MIT-STARLab/CLICK-A-Electronics/README.md

# CLICK-A-Electronics
Electronics for the CLICK-A payload
