MIT-STARLab/CLICK-A-Electronics/FPGA/BOM_FPGAboard.xlsx

Quantity | Designator | Manufacturer Part Number | Manufacturer | Supplier | Supplier Part Number | Description
1 | U4 | XC6SLX9-3TQG144I | Xilinx | Digikey | 122-1748-ND (https://octopart-clicks.com/click/altium?sku=122-1748-ND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) | IC FPGA 102 I/O 144TQFP
4 | SW1_B, SW1_E, SW1_H, SW1_T | TPS27082LDDCR | Texas Instruments (TI) | Digikey | 296-35595-1-ND (https://octopart-clicks.com/click/altium?sku=296-35595-1-ND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) | IC LOAD SW HIGH SIDE 6SOT
1 | CON3 | T1M-10-F-SH-L-K | Samtec | Digikey | SAM11993-ND (https://octopart-clicks.com/click/altium?sku=SAM11991-ND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) | 10 Positions Header Connector Surface Mount, Right Angle
1 | CON1 | T1M-06-F-SH-L-K | Samtec | Digikey | SAM11991-ND (https://octopart-clicks.com/click/altium?sku=SAM11991-ND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) | 6 Positions Header Connector Surface Mount, Right Angle
1 | U3 | CY7C68014A-56PVXC | Cypress | Digikey | 428-1673-ND (https://octopart-clicks.com/click/altium?sku=428-1673-ND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) | IC MCU USB PERIPH HI SPD 56SSOP
1 | U5 | LTM | Diodes / Zetex | Digikey | ZLDO1117G12DICT-ND (https://octopart-clicks.com/click/altium?sku=ZLDO1117G12DICT-ND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) | Linear Voltage Regulator IC Positive Fixed Output 1.2V 1A SOT-223-3
1 | U6 | PRTR5V0U2X,215 | NXP Semiconductors | Digi-Key | 1727-3884-1-ND (https://octopart-clicks.com/click/altium?sku=1727-3884-1-ND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) | TVS DIODE 5.5VWM SOT143B
1 | U7 | SN74LVC1G04QDBVRQ1 | Texas Instruments | Digi-Key | 296-26588-1-ND (https://octopart-clicks.com/click/altium?manufacturer=Texas%20Instruments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) | IC SNGL INVERTER GATE
1 | SW2 |  | ITT / C&K Components | C&K Components | CKN9112CT-ND (https://octopart-clicks.com/click/altium?manufacturer=Supplier%20disabled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) | PTS645SM43SMTR92 LFS
4 | P1, P2, P3, P4
1 | MCX | 73415-1066 | Molex |  |  | 73415-1061 Substitute may be OK (Contact customer for final approval)
4 | U1_B, U1_E, U1_H, U1_T | MCP6N11 | Microchip | Digi-Key | MCP6N11-010E/SN-ND (https://octopart-clicks.com/click/altium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) | IC OPAMP INSTR 35MHZ RRO 8SOIC
4 | U2_B, U2_E, U2_H, U2_T | MAX1240CESA+ | Maxim | Digikey | MAX1240CESA+-ND (https://octopart-clicks.com/click/altium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) | IC ADC 12BIT SERIAL 8-SOIC
1 | CON2 | LSEM-150-06.0-L-DV-A-N-K-TR | Samtec | Samtec | LSEM-150-06.0-L-DV-A-N-K-TR
1 | CON4 |  |  |  |  | Header, 13-Pin, Dual row
1 | CON5 |  |  |  |  | Header, 10-Pin
1 | Y1 | AT-24.000MAGE-T | TXC | Digikey | 887-1613-1-ND (https://octopart-clicks.com/click/altium?sku=887-1613-1-ND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) | 24MHz ±30ppm Crystal 12pF 50 Ohm -40°C ~ 85°C AEC-Q200 Surface Mount HC49/US
4 | R1_B, R1_E, R1_H, R1_T | WSLP0805R0100FEB | Vishay Dale | Digi-Key | WSLPB-.01CT-ND (https://octopart-clicks.com/click/altium?sku=WSLPB-.01CT-ND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) | 10 mOhms ±1% 0.5W, 1/2W Chip Resistor 0805 (2012 Metric)
4 | R2_B, R2_E, R2_H, R2_T | CRCW0805127KFKEA | Vishay | Digikey | 541-127KCCT-ND (https://octopart-clicks.com/click/altium?sku=541-127KCCT-ND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)
7 | R3_B, R3_E, R3_H, R3_T, R6, R9, R10 | CRCW080510K0FKEA_ | Vishay | Digikey | 541-10.0KCCT-ND (https://octopart-clicks.com/click/altium?sku=541-10.0KCCT-ND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)
4 | R4_B, R4_E, R4_H, R4_T | CRCW0805100RDHEAP | Vishay Dale | Digi-Key | 541-100AZCT-ND (https://octopart-clicks.com/click/altium?sku=541-100AZCT-ND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) | RES SMD 100 OHM 0.5% 1/8W 0805
5 | R5_B, R5_E, R5_H, R5_T, R11 | CRCW08050000Z0EA | Vishay | Digikey | 541-0.0ACT-ND (https://octopart-clicks.com/click/altium?sku=541-0.0ACT-ND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)
2 | R7, R8 | CRCW08052K20FKEA | Vishay | Digikey | 541-2.20KCCT-ND (https://octopart-clicks.com/click/altium?sku=541-2.20KCCT-ND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)
1 | OSC1 | ASVMB-100.000MHZ-XY-T | Abracon | Digikey | 535-11246-1-ND (https://octopart-clicks.com/click/altium?sku=535-11246-1-ND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)
6 | C3_B, C3_E, C3_H, C3_T, C28, C29 | C1210C476M8RAC7800 | Kemet | Digikey | 399-12072-1-ND (https://octopart-clicks.com/click/altium?sku=399-12072-1-ND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)
10 | C1_B, C1_E, C1_H, C1_T, C4_B, C4_E, C4_H, C4_T, C24, C25 | C0805C106M8RACTU | Kemet | Digikey | 399-7413-1-ND (https://octopart-clicks.com/click/altium?sku=399-7413-1-ND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)
2 | C20, C23 | C0805C474K5RACTU | Kemet | Digikey | 399-8100-1-ND (https://octopart-clicks.com/click/altium?sku=399-8100-1-ND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)
2 | C21, C22 | C0805C120J5GACTU | Kemet | Digikey | 399-1110-1-ND (https://octopart-clicks.com/click/altium?sku=399-1110-1-ND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)
38 | C2_B, C2_E, C2_H, C2_T, C5_B, C5_E, C5_H, C5_T, C6, C7, C8, C9, C10, C11, C12, C13, C14, C15, C16, C17, C18, C19, C26, C27, C30, C31, C32, C33, C34, C35, C36, C37, C38, C39, C40, C41, C42, C43 | C0805C104K5RACTU | Kemet | Digikey | 399-1170-1-ND (https://octopart-clicks.com/click/altium?sku=399-1170-1-ND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)
