MIT-STARLab/CLICK-A-Electronics/Rpi Board/RPIadaptorV3_BOM.xlsx

MPN | Designator | LibRef | Supplier 1 | Supplier Part Number 1 | Description | Quantity | Value
C1210C476M9PACTU (https://www.digikey.com/product-detail/en/kemet/C1210C476M9PACTU/399-4961-1-ND/1090956) | C4, C20, C26 | C1210C476M8RAC7800 | Digikey | 399-12072-1-ND |  | 3
C0805C106M8RACTU | C5, C16, C17 | C0805C106M8RACTU | Digikey | 399-7413-1-ND |  | 3
GRT21BC80G476ME13L (https://www.digikey.com/product-detail/en/murata-electronics/GRT21BC80G476ME13L/490-12339-1-ND/5417040) | C6, C7 | CAP 0805 |  |  | 0805 CAP, 805 Capacitor | 2 | 47uF
CL05F104ZO5NNNC | C8, C23, C31, C32, C35, C36, C37, C39, C40, C42, C44 | CAP 0402 |  |  | [NoValue], 402 Capacitor, CBR04C680F3GAC, 402 cap | 11 | [NoValue], .1uF
C0603C104Z3VACTU (https://www.digikey.com/product-detail/en/kemet/C0603C104Z3VACTU/399-1100-1-ND/411375) | C9 | CAP 0603 |  |  | 603 Capacitor | 1
C0402C270K5GACTU (https://www.digikey.com/product-detail/en/kemet/C0402C270K5GACTU/399-8960-1-ND/3522477) | C10, C11 | CAP 0402 |  |  |  | 2
GRM21BR60J476ME15L | C14 | CMP-1036-04876-1 |  |  | GRM21BR60J476ME15L | 1 | 4.7uF
C0805C104K5RACTU (https://www.digikey.com/product-detail/en/kemet/C0805C104K5RACTU/399-1170-1-ND/411445) | C15, C18, C19, C25, C27 | C0805C104K5RACTU | Digikey | 399-1170-1-ND |  | 5
GRM21BR61E226ME44L (https://www.digikey.com/product-detail/en/murata-electronics/GRM21BR61E226ME44L/490-10749-1-ND/5251351) | C24, C28 | CAP 0805 |  |  | 805 Capacitor | 2
GRM21BR61A226ME51L (https://www.digikey.com/product-detail/en/murata-electronics/GRM21BR61A226ME51L/490-10511-1-ND/5026441) | C29 | CAP 0805 |  |  | 805 Capacitor | 1
GRM188C81E475KE11D (https://www.digikey.com/product-detail/en/murata-electronics/GRM188C81E475KE11D/490-7199-1-ND/3900424) | C30 | CMP-1035-01192-1 |  |  | GRM188C81E475KE11D | 1
CC0805KRX5R5BB475 (https://www.digikey.com/product-detail/en/yageo/CC0805KRX5R5BB475/311-3422-1-ND/7164443) | C38 | CAP 0805 |  |  | 805 Capacitor | 1
C0402C105K9PACTU (https://www.digikey.com/product-detail/en/kemet/C0402C105K9PACTU/399-4873-1-ND/1090868) | C41, C45, C47 | CAP 0402 |  |  | [NoValue], 402 cap, 402 | 3
CC0402KRX7R9BB332 (https://www.digikey.com/product-detail/en/yageo/CC0402KRX7R9BB332/311-1034-1-ND/302951) | C43 | CAP 0402 |  |  |  | 1
GJM1555C1H140GB01D (https://www.digikey.com/product-detail/en/murata-electronics/GJM1555C1H140GB01D/490-14443-1-ND/6606904) | C46, C48 | CAP 0402 |  |  | CBR04C680F3GAC | 2
T1M-06-F-SH-L-K | CON1, CON2, CON6 | T1M-06-F-SH-L-K | Digi-Key | SAM11991-ND | 6 Positions Header Connector Surface Mount, Right Angle | 3
0532610671 | CON3 | 0532610671 | Digi-Key | WM7624CT-ND | CONN HEADER 6POS 1.25MM R/A SMD | 1
T1M-10-F-SH-L-K | CON4 | T1M-10-F-SH-L-K |  |  | 10 Positions Header Connector Surface Mount, Right Angle | 1
1473005-4 | CON5 | 1473005-4 | Digikey | A114851-ND |  | 1
929834-01-36-RK (https://www.digikey.com/product-detail/en/3m/929834-01-36-RK/3M156862-36-ND/1239201) | CON7 | 1X6 Header |  |  |  | 1
 | P1 | Header 5X2 |  |  | Header, 5-Pin, Dual row | 1
 | P2 | Header 10 |  |  | Header, 10-Pin | 1
 | P3 | Header 9X2 |  |  | Header, 9-Pin, Dual row | 1
 | P4, P5, P6, P7 | Plug |  |  | Plug | 4
DMG1012T-7 | Q1, Q2 | DMG1012T-7 | Digikey | DMG1012T-7DICT-ND | N-Channel MOSFET | 2
 | R1, R2, R23, R24 | RES 0402 |  |  | 402 Resistor | 4
ERA-2AEB473X (https://www.digikey.com/product-detail/en/panasonic-electronic-components/ERA-2AEB473X/P47KDCCT-ND/1706223) | R7, R8, R21, R22, R26 | RES 0402 |  |  | 402 Resistor | 5
CRCW080510K0FKEA_ESTE | R9 | CRCW080510K0FKEA_ESTE | Digikey | 541-10.0KCCT-ND |  | 1
ERA-2AEB1332X (https://www.digikey.com/product-detail/en/panasonic-electronic-components/ERA-2AEB1332X/P13-3KDCCT-ND/3063672) | R14 | RES 0402 |  |  | 402 Resistor | 1
RT0402BRD078K25L (https://www.digikey.com/product-detail/en/yageo/RT0402BRD078K25L/YAG1487CT-ND/5138935) | R15 | RES 0402 |  |  | 402 Resistor | 1
ERA-3AEB3243V (https://www.digikey.com/product-detail/en/panasonic-electronic-components/ERA-3AEB3243V/P324KDBCT-ND/3075930) | R16 | RES 0603 |  |  | 603 Resistor | 1
ERA-2AEB123X (https://www.digikey.com/product-detail/en/panasonic-electronic-components/ERA-2AEB123X/P12KDCCT-ND/1706209) | R17 | RES 0402 |  |  | 402 Resistor | 1
ERJ-2GEJ102X (https://www.digikey.com/product-detail/en/panasonic-electronic-components/ERJ-2GEJ102X/P1-0KJCT-ND/146897) | R20 | RES 0402 |  |  | 402 Resistor | 1
ERA-2AEB4021X (https://www.digikey.com/product-detail/en/panasonic-electronic-components/ERA-2AEB4021X/P4-02KDCCT-ND/3063803) | R25 | RES 0402 |  |  | 402 Resistor | 1
RC0402FR-07100KL (https://www.digikey.com/product-detail/en/yageo/RC0402FR-07100KL/311-100KLRCT-ND/729473) | R27 | RES 0402 |  |  | 402 Resistor | 1
ERA-2AED103X (https://www.digikey.com/product-detail/en/panasonic-electronic-components/ERA-2AED103X/P10KDECT-ND/1706304) | R32 | RES 0402 |  |  | 402 Resistor | 1
LTM4622IY | U1 | LTM4622 |  |  | Dual Ultrathin 2.5A or Single 5A Step-Down DC/DC µModule Regulator | 1
LM1117MPX-1.8/NOPB | U2 | LM1117MPX-1.8/NOPB | Digikey | LM1117MPX-1.8/NOPBCT-ND | LDO | 1
PRTR5V0U2X,215 | U3, U6 | PRTR5V0U2X,215 | Digi-Key | 1727-3884-1-ND | TVS DIODE 5.5VWM SOT143B | 2
USB2422T-I/MJ (https://www.digikey.com/product-detail/en/microchip-technology/USB2422T-I-MJ/USB2422T-I-MJDKR-ND/8637360) | U4 | USB2422 |  |  |  | 1
TPS259573DSGR (https://www.digikey.com/product-detail/en/texas-instruments/TPS259573DSGR/296-50501-1-ND/9685640) | U5 | TPS2595x3 |  |  |  | 1
FSUSB42MUX | U7 | FSUSB42 | Digikey | FSUSB42MUXDKR-ND | 2 ports USB switch | 1
SN65LVDS33D | U8 | SN65LVDS33 |  |  |  | 1
SN65LVDS9638DR | U9 | SN65LVDS9638 |  |  |  | 1
VNC2-48L1C-REEL | U10 | VNC2L |  |  |  | 1
7A-12.000MAAE-T | Y2 | 7A-12.000MAAE-T |  |  |  | 1
7A-24.000MAAE-T (https://www.digikey.com/product-detail/en/txc-corporation/7A-24-000MAAE-T/887-1751-1-ND/3518801) | Y3 | 7A-12.000MAAE-T |  |  |  | 1
