MIT-STARLab/CLICK-A-Electronics/Photodiode Board/PhotodiodeBoard.xlsx

Comment | Description | Designator | Footprint | LibRef | Quantity
0.1uF |  | C1, C2, C5, C12, C14, C16, C17, C20, C22, C23, C26, C29, C32 | 0402 | Cap 0402 | 13
2.2uF |  | C3, C6, C11, C18, C21, C24, C27, C28, C31 | 0402 | Cap 0402 | 9
1000p |  | C4, C19, C25 | 0402 | Cap 0402 | 3
22uF |  | C7, C8, C10 | 0603 | Cap 0603 | 3
.1uF |  | C9 | 0402 | Cap 0402 | 1
10uF | tantalum bead type cap | C13 | 0603 | Cap 0603 | 1
10p |  | C15, C30, C33 | 0402 | Cap 0402 | 3
T1M-15-F-SH-L-K |  | CON1 | T1M-15-F-SH-L-K | T1M-15-F-SH-L-K | 1
EPM605 |  | D1, D3, D5 | EPM605 | EPM605 | 3
1N4148 | Fast switching diode SMD | D2, D4, D6 | SOD3716X135N | 1N4148 | 3
0 |  | R1, R13, R24 | 0402 | Res 0402 | 3
20K |  | R2, R8, R14, R20, R25, R32 | 0402 | Res 0402 | 6
15K |  | R3, R15, R26 | 0402 | Res 0402 | 3
49.9 |  | R4, R16, R27 | 0402 | Res 0402 | 3
DNP | 0 ohm | R5, R6, R17, R18, R29, R30 | 0402 | Res 0402 | 6
1K |  | R7, R19, R31 | 0402 | Res 0402 | 3
22K |  | R9, R11, R21, R23, R33, R35 | 0402 | Res 0402 | 6
2K |  | R10, R22, R34 | 0402 | Res 0402 | 3
6.65K |  | R12, R28, R36 | 0402 | Res 0402 | 3
LTC6752 |  | U1, U2, U4, U5, U6, U8, U9, U10, U12 | TSOT-23 5 Lead | LTC6752 | 9
LTC6268-10 |  | U3, U7, U11 | TSOT-23 6 Lead | LTC6268-10 | 3
AD5666ARUZ-2REEL7 | Integrated Circuit | U13 | TSSOP-14 | AD5666ARUZ-2REEL7 | 1
