MIT-STARLab/CLICK-A-Electronics/Daughterboard/Daughter_Board_rev_16_updated.xls

Manufacturer part number | Comment | Description | Designator | Footprint | LibRef | Quantity
LMF105B7102MVHF | 1000pF | 0402 (1005 Metric) Nick Garner - TeleSense | C1, C32, C33, C34 | 0402 B | CAP_0402 | 4 | x
C0603C106M8PACTU | 10uF | CAPACITOR, European symbol | C2, C5, C8, C11, C14, C17, C29, C57, C88 | 603 | C-EUC0603K | 9 | x
C0402C104M4RECTU | 0.1uF | CAPACITOR, European symbol, 0402 (1005 Metric) Nick Garner - TeleSense | C3, C6, C9, C12, C15, C18, C19, C20, C21, C22, C23, C25, C26, C27, C37, C38, C43, C44, C53, C55, C48, C49, C50, C51, C52,C56,C80,C83,C86 | 0402 B | C-EUC0402K, CAP_0402, C-EUC0402 | 30 | x
C0603C105Z3VACTU | 1uF | CAPACITOR, European symbol | C4, C16 | 603 | C-EUC0603 | 2 | x
GRM188R60J226MEA0D | 22uF | CAPACITOR, European symbol | C7, C13, C79 | 603 | C-EUC0603 | 3 | x
C1812C106K3RACAUTO | 10uF | CAPACITOR, European symbol | C10 | C1812 | C-EUC1812 | 1 | x
DNI | C-EUC0603 | CAPACITOR, European symbol | C24 | 603 | C-EUC0603 | 1
C0603C104Z3VACTU | 0.1uF | CAPACITOR, European symbol | C28, C30, C31, C35, C74, C81 | 603 | C-EUC0603K, C-EUC0603 | 5 | x
CC0402KPX5R7BB105 | 1uF | 402 Capacitor | C36, C39, C60,C45, C46, C47, C76 | 0402 B | CAP 0402 | 7 | x
C0603X103K1RAC3316 | 0.01uF | CAPACITOR, European symbol | C40, C41 | 603 | C-EUC0603K | 2 | x
C0402C473K3RECTU | 47nF | 402 Capacitor | C42 | 0402 B | CAP 0402 | 1 | x
C0402C332K5RECAUTO | 3.3nF | 402 Capacitor | C54 | 0402 B | CAP 0402 | 1 | x
C0402C474K9PAC | 47pF | 402 Capacitor | C58 | 0402 B | CAP 0402 | 1 | x
GRM188R60J476ME15J | 47uF |  | C59 | 603 | Cap 0603 | 1 | x
C0402C106M9PACTU | 10uF | 402 Capacitor | C61, C64 | 0402 B | CAP 0402 | 2 | x
12066D107MAT2A | 100uF | 1206 Capacitor | C62 | 1206 B | CAP 1206 | 1 | x
C0402C820J3GACAUTO | 82pF | 402 Capacitor | C63 | 0402 B | CAP 0402 | 1 | x
C0402T103J4RACTU | 10nF | 402 Capacitor | C65 | 0402 B | CAP 0402 | 1 | x
TMK107BBJ475MA-T | 4.7uF | CAPACITOR, European symbol | C75 | 603 | C-EUC0603 | 1 | x
AMK105EBJ226MV-F | 22uF | CAPACITOR, European symbol | C77, C78 | 402 | C-EUC0402 | 2 | digikey
C0402S331K5RAC7867 | 330pF | CAPACITOR, European symbol | C82 | 402 | C-EUC0402 | 1 | x
T1M-07-F-SH-L-K | T1M-07-F-SH-L-K | 6 Positions Header Connector Surface Mount, Right Angle | CON1,CON4 | T1M-07-F-SH-L-K | T1M-07-F-SH-L-K_1 | 2 | x
T1M-06-F-SH-L-K | T1M-06-F-SH-L-K | 6 Positions Header Connector Surface Mount, Right Angle | CON2, CON3 | T1M-06-F-SH-L-K | T1M-06-F-SH-L-K | 2 | x
 | DNP | SAMTEC connector | CON5 | LSEM-150-XX.X-X-DV-A-X-XX-TR | SAMTEC_LSEM_V_50 | 1
MBR120VLSFT1G | MBR120VLSFT1G | DIODE SCHOTTKY 20V 1A | D1 | SOD123FL | MBR120VLSFT1G | 1 | x
MM3Z5V1ST1GOSCT-ND | MM3Z5V1ST1GOSCT-ND | MM3Z5V1ST1GOSCT-ND | D4 | SOD-323 | DIODE-ZENER3.3V | 1 | digikey
GF1G | GF1G | DIODE | D5 | SMA-DO214AC | GF1 | 1 | x
MM3Z3V3T1GOSCT-ND | MM3Z3V3T1GOSCT-ND | Zener Diode Production Part - 8199 3.4V Zener Voltage | D6 | SOD-323 | DIODE-ZENER3.3V | 1 | digikey
MCP1541 | MCP1541 | 2.5V and 4.096V Voltage ReferencesSource: http://www.microchip.com .. 21653b.pdf | U4 | SOT-23 | MC15*TT | 1 | x
CBC2518T100M | CBC2518T100M |  | L1 | 1007 | CBC2518T100M | 1 | x
NLC453232T-330K-PF | 33uH | INDUCTOR, American symbol | L3 | L1812 | L-USL1812 | 1 | x
74479763210 | FERRITE | InductorsBasic Inductor/Choke - 0603 and 1206. Footprints are not proven and vary greatly between part numbers.SRN6045- 33uH, 20% 1.4ASDR0403-560KL - 56uH, 10%, 500mA RMS/740mA peak | L5, L9, L10 | 0603R | INDUCTOR0603 | 3 | x
B82462G4103M | B82462G4103M | 10uH | L11, L12 | B82462G | INDUCTOR-B82462G | 2 | x
ERA-3AEB102V | 1k | RESISTOR, American symbol | R1, R2, R3, R4, R5, R7, R8, R9, R10, R11, R13, R14, R15, R16, R17, R19, R20, R21, R22, R23, R25, R26, R27, R28, R29, R31, R32, R33, R34, R35, R56, R77 | 0603R | R-US_R0603 | 32 | x
RCS06030000Z0EC | 0 | RESISTOR, American symbol | R6, R12, R18, R24, R30, R36 | 0603R | R-US_R0603 | 6 | x
SR0603FR-7T100RL | 100 | RESISTOR, American symbol | R37 | 0603R | R-US_R0603 | 1 | x
RN73R1JTTD1002B50 | 10k | RESISTOR, American symbol | R38, R59, R86 | 0603R | R-US_R0603 | 3 | x
 | DNP | RESISTOR, American symbol | R39 | 0603R | R-US_R0603 | 1
RC0402FR-0710KL | 10K | 402 Resistor | R40 | 402 | RES 0402 | 1 | x
PNM0402E5001BST1 | 18K2 | 402 Resistor | R41 | 402 | RES 0402 | 1 | x
ERA-2AEB303X | 30K | 402 Resistor | R42 | 0402R | RES 0402 | 1 | x
CRCW06034M99FKEA | 4.99M | RESISTOR, American symbol | R44, R45, R46, R47 | 0603R | R-US_R0603 | 4 | x
CRCW060390K9FKEAC | 90.9k | RESISTOR, American symbol | R48, R49, R50, R51 | 0603R | R-US_R0603 | 4 | x
ERA-3AEB104V | 100k | RESISTOR, American symbol | R52, R53, R57, R72, R73 | 0603R | R-US_R0603 | 5 | x
CSR1206FTR100 | 0.1 | RESISTOR, American symbol | R54 | 1206R | R-US_R1206 | 1 | Digikey
ERA-3AEB9091V | 9.09k | RESISTOR, American symbol | R55 | R0603 | R-US_R0603 | 1 | x
MCT06030C1005FP500 | 10M | RESISTOR, American symbol | R58 | 0603R | R-US_R0603 | 1 | x
CPF0603F6R81C1 | 6.81 | RESISTOR, American symbol | R60 | R0603 | R-US_R0603 | 1 | x
ERA-3AEB433V | 43k | RESISTOR, American symbol | R71 | 0603R | R-US_R0603 | 1 | x
ERA-3AEB1273V | 127k | RESISTOR, American symbol | R74 | 0603R | R-US_R0603 | 1 | x
RC1206JR-077M5L | 7.5M | RESISTOR, American symbol | R75 | 1206R | R-US_R1206 | 1 | x
MCT06030C3162FP500 | 31.6k | RESISTOR, American symbol | R76 | 0603R | R-US_R0603 | 1 | x
CRGCQ0402F82K | 82k | RESISTOR, American symbol | R83 | 0402R | R-US_R0402 | 1 | x
RC0402FR-0710KL | 10k | RESISTOR, American symbol | R84, R85 | 0402R | R-US_R0402 | 2 | x
TPS259541DSGR | TPS259541DSGR |  | U1 | SON8 (2x2) | TPS2595x3 | 1 | x
iC-WKN | iC-WKN |  | U2 | SOIC8tp | iC-WKN | 1 | iC-Haus
TPS6735IDR | TPS6735 |  | U3 | SOIC8 | TPS6735 | 1 | x
T1M-15-F-SH-L-K | T1M-15-F-SH-L-K |  | U5 | T1M-15-F-SH-L-K | T1M-15-F-SH-L-K | 1 | x
TLV5619IPW | TLV5619 |  | U6 | TSSOP-20 | TLV5619 | 1 | x
MCP6N11-001E/SN | MCP6N11 |  | U7, U9, U11, U17, U25, U29 | SOIC8 | MCP6N11 | 6 | x
MAX1240AESA+ | MAX1240 |  | U8, U10, U12, U21, U28, U30,U37 | SOIC8 | MAX1240 | 7 | x
AD5664RBRMZ-5 | AD5664R |  | U13 | MSOP10 | AD5664R | 1 | x
HV264 | HV264 |  | U14 | TSSOP24 | HV264 | 1 | microchip
MAX7413EUA+ | MAX7413 |  | U15, U16, U18, U19 | UMAX8 | MAX7413 | 4 | x
LTC1923EGN#PBF | LTC1923SSOP28 |  | U20 | SSOP28 | LTC1923SSOP28 | 1 | x
SI9801DY | SI9801DY |  | U22, U23 | SOIC8 | SI9801DY | 2 | utsource
LTC2053IMS8#PBF | LTC2053 |  | U24 | MSOP8 | LTC2053 | 1
TPS27082LDDCR | TPS27082L |  | U26, U27 | TSOT-23 6 Lead | TPS27082L | 2 | digikey
SI2334DS | SI2334DS |  | U31 | SOT-23 | SI2334DS | 1 | x
ADN8810ACPZ-ND | ADN8810 |  | U32 | LFCSP24 | ADN8810 | 1 | x
SHF-105-01-L-D-RA | SHF-105-01-L-D-RA |  | CON6 | SHF-105-01-L-D-RA | SHF-105-01-L-D-RA | 1 | x
ADUM7440CRQZ | ADUM7440 |  | U35 | QSOP16 | ADUM7440 | 1 | x
HV9150 | HV9150 |  | U42 | QFN3X3-6 | HV9150 | 1 | x
BSZ42DN25NS3 | BSZ42DN25NS3 |  | U43 | TDSON-8 | BSZ42DN25NS3 | 1 | x
TC33X-2-204E | 200k | SMT trimmer potentiometer part number TC33X http://www.ladyada.net/library/eagle | U44 | TC33X | TRIMPOTTC33X | 1 | x
791077014 | 87758-3016 | 30 Pin - 2mm Dual Row Single Wafer, Vertical T/H HDRSource: http://www.molex.com/pdm_docs/sd/877580616_sd.pdf | X1 | 87758-3016 | 87758-3016 | 1 | x
