MIT-STARLab/CLICK-A-Electronics/Calibration Laser Board/Calibration_Laser_Board.step

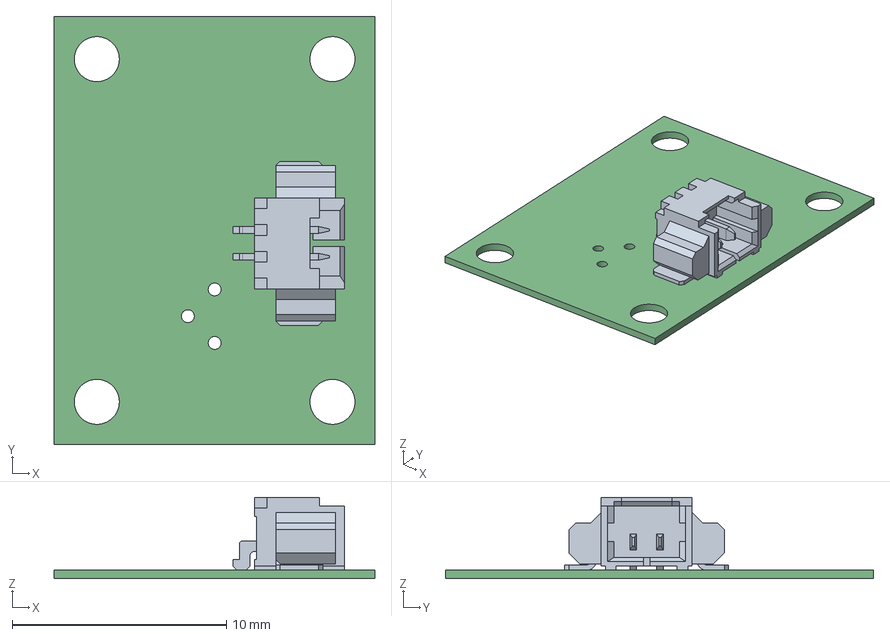
[picture p1: CAD file, 2020-10-06]
Calibration Laser Board/Calibration_Laser_Board.step
15.0 x 20.0 x 3.79 mm
Board
