MIT-STARLab/CLICK-A-Electronics/Photodiode Board/Photodiode Board.pdf

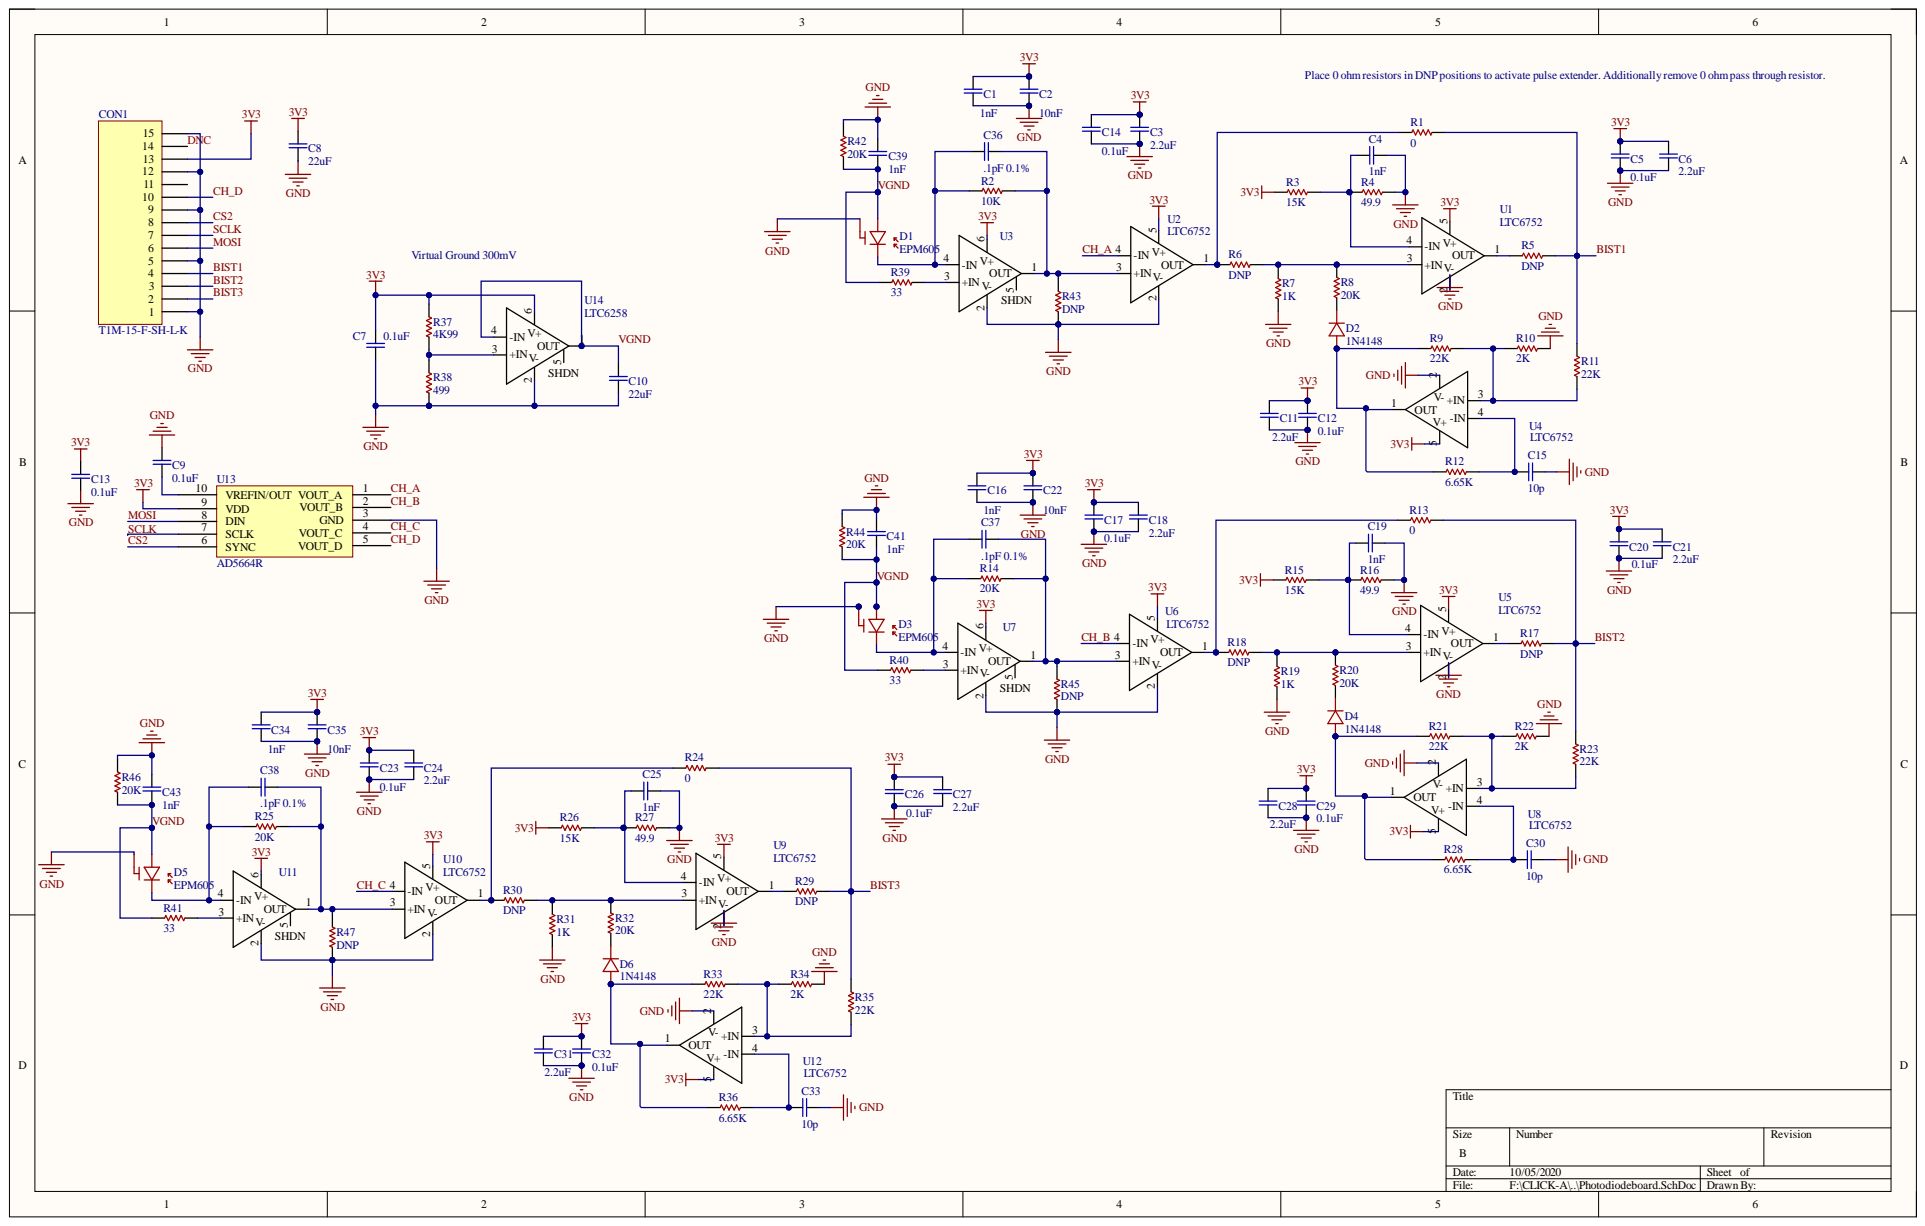
[picture p2: page 1]

Place 0 ohmresistors in DNP positions to activate pulse extender. Additionally remove 0 ohmpass through resistor.

Size B | Number | Revision

Date: 10/05/2020 | Sheet of
File: F:\CLICK-A\..\Photodiodeboard.SchDoc | DrawnBy:

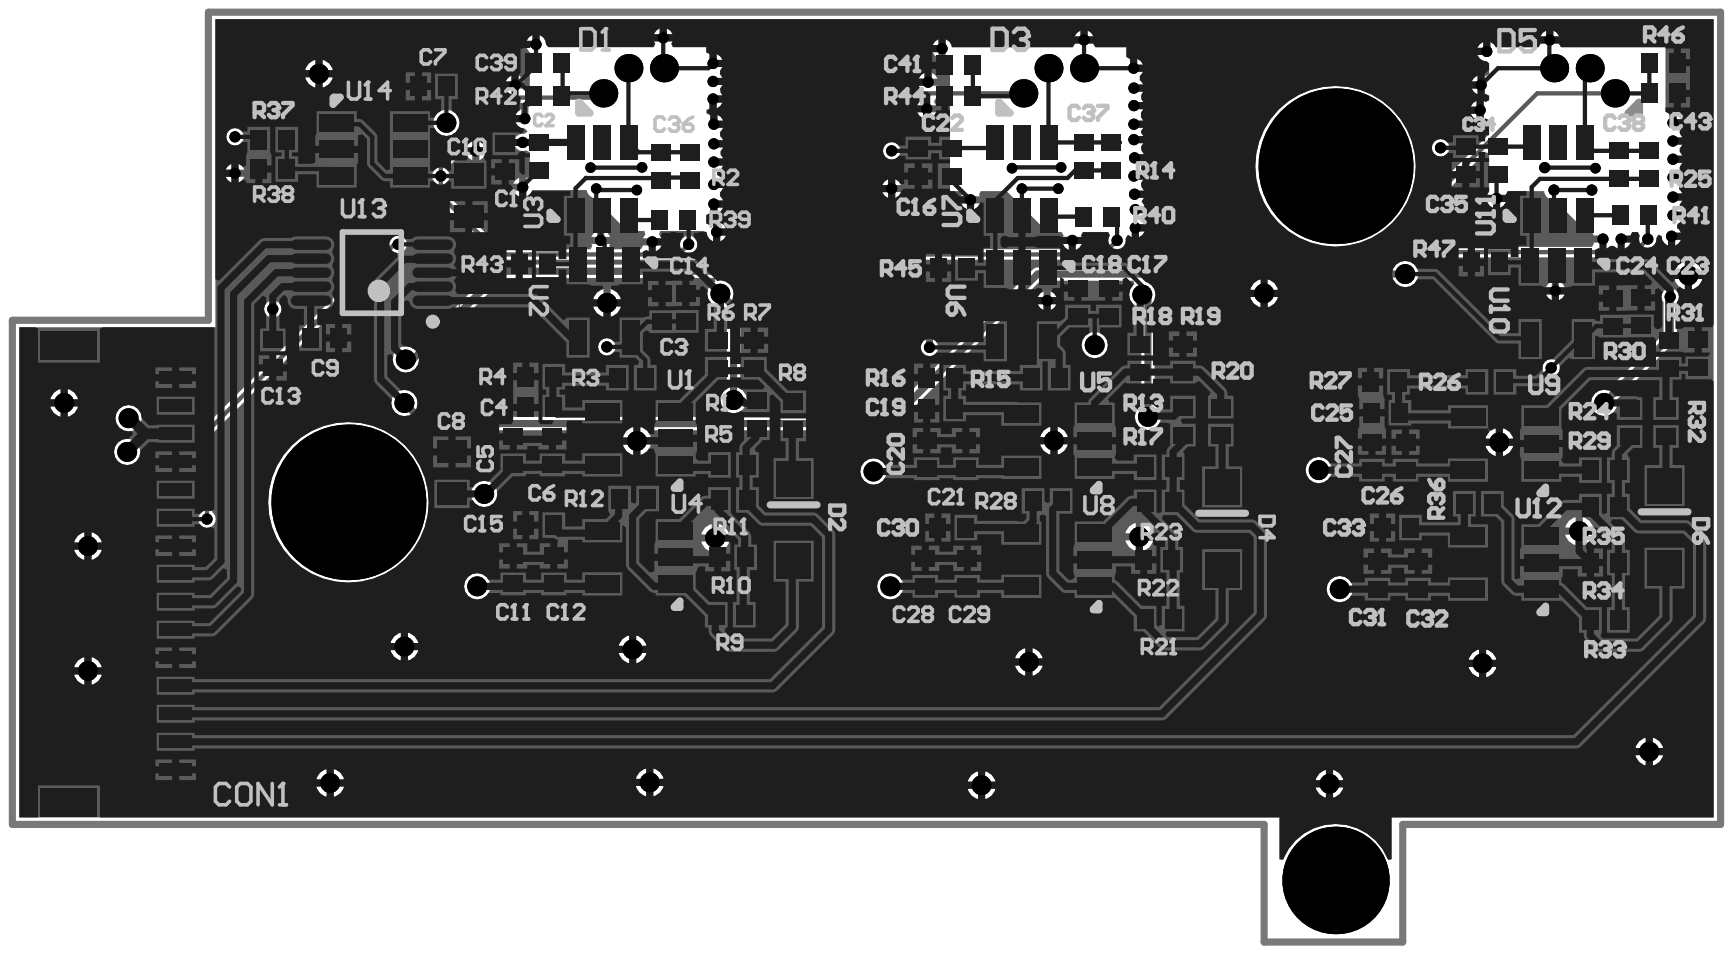
[picture p3: page 2]
