MIT-STARLab/CLICK-A-Electronics/Daughterboard/NODE_Daughter_Board_rev_16.pdf

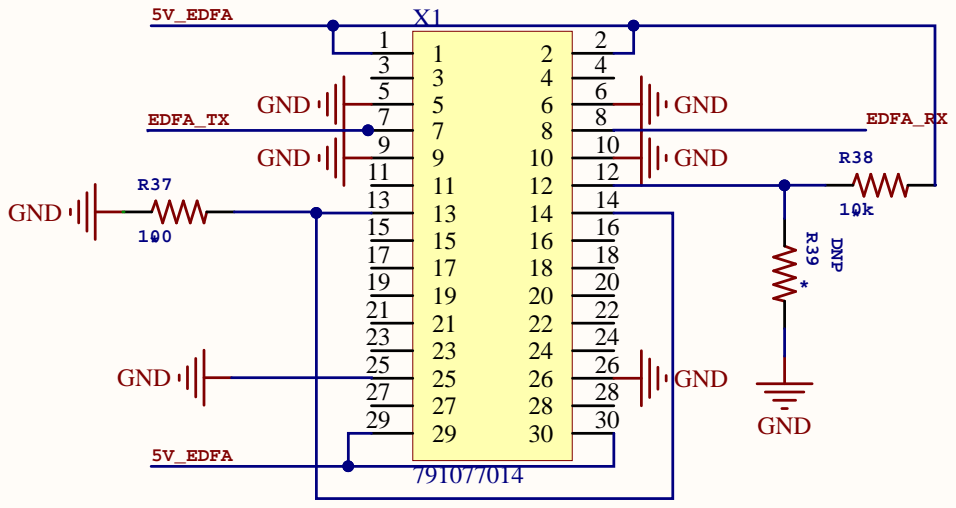
[picture p4: page 1]

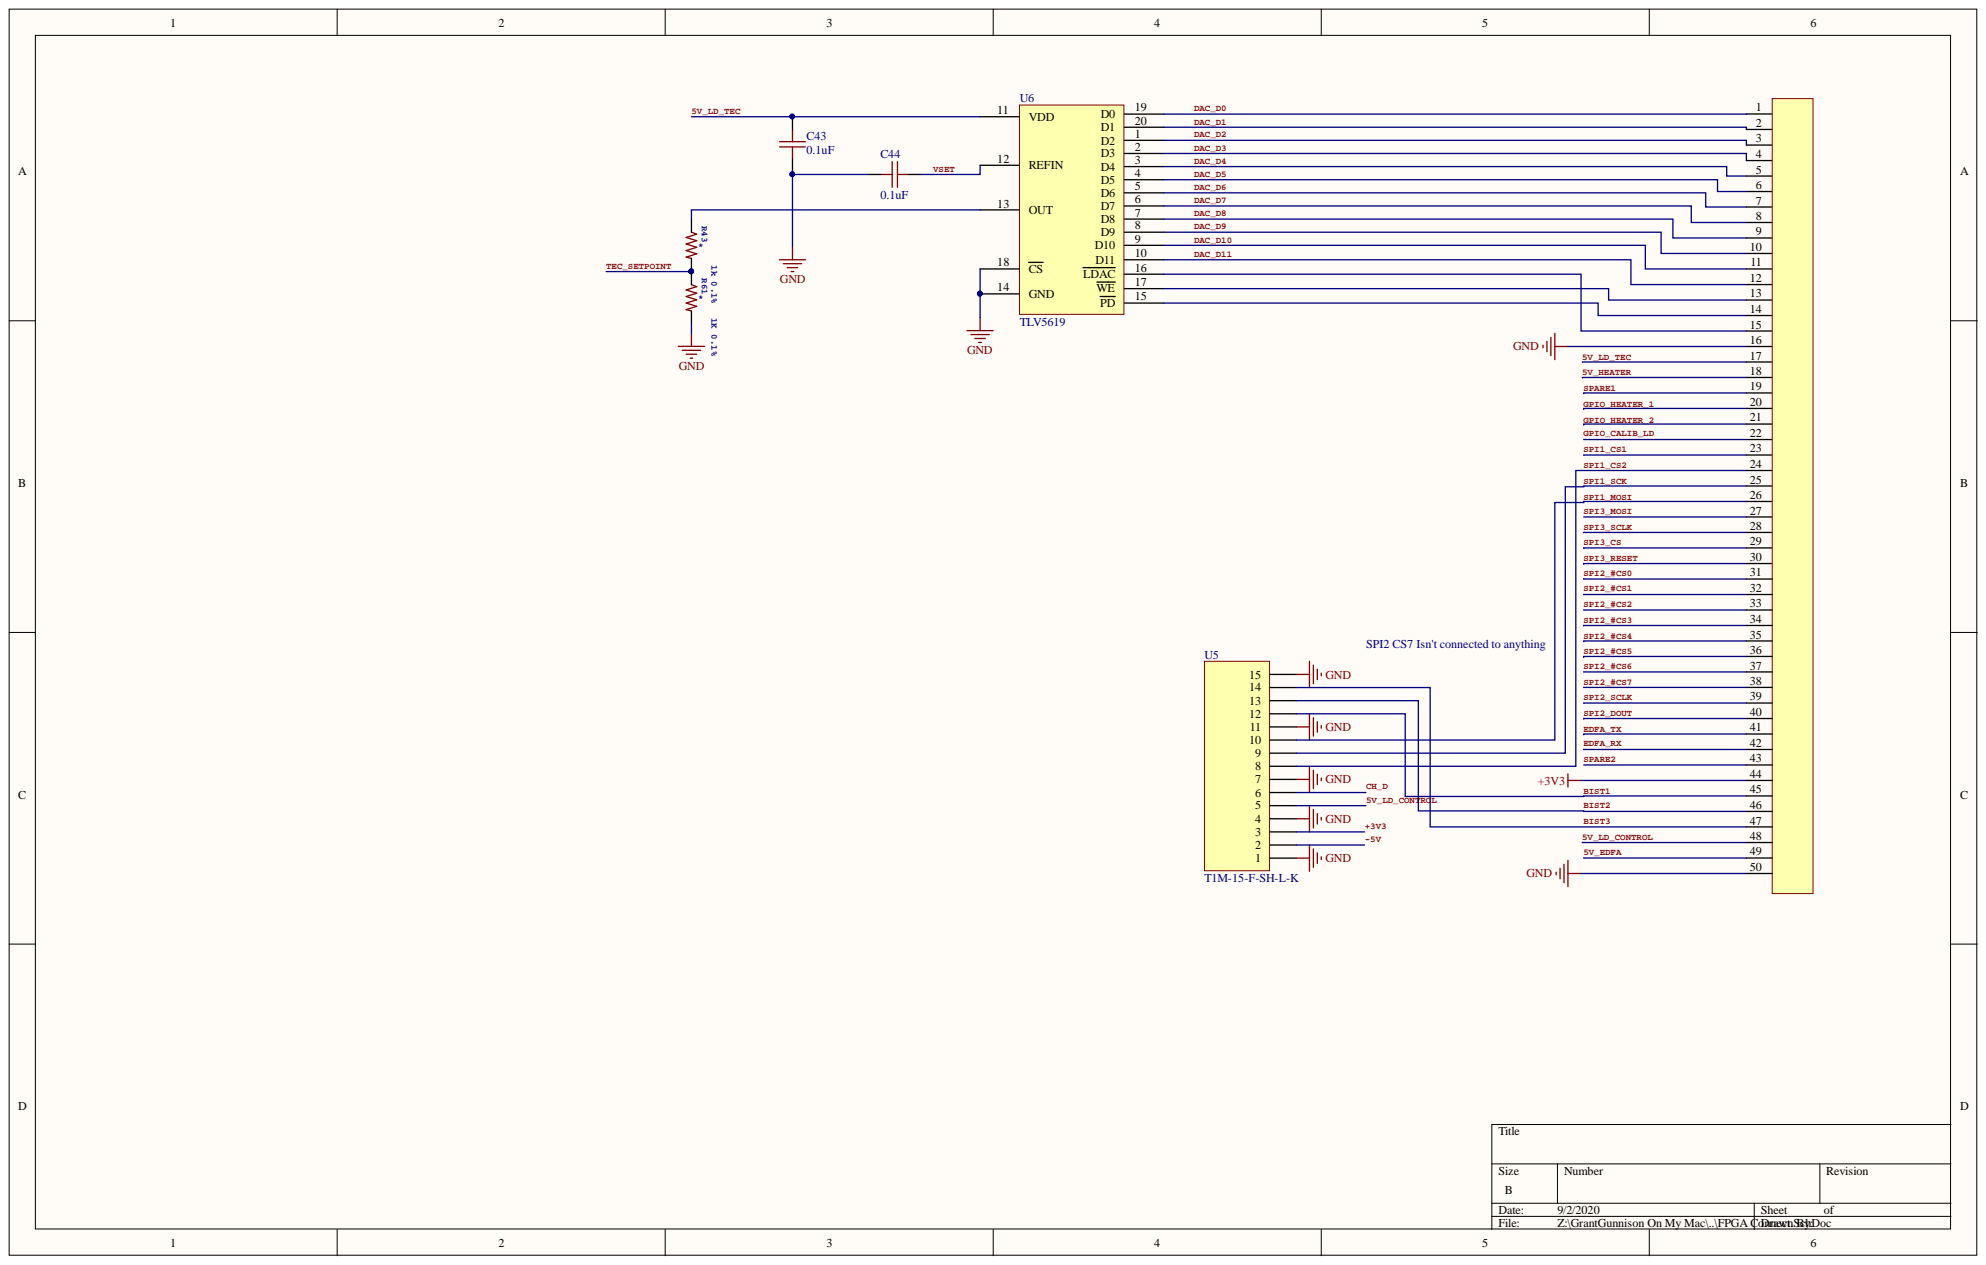
[picture p5: page 2]

A Connect Drawn B.SchDy: oc 123456789

5 | DAC_D6
6 | DAC_D7
7 | DAC_D8
8 | DAC_D9

DAC_D10 | 1011

12
13
14

SPI1_SCK | 25
SPI1_MOSI | 26
SPI3_MOSI SPI3_SCLK SPI3_CS SPI3_RESET SPI2_#CS0 SPI2_#CS1 SPI2_#CS2 SPI2_#CS3 SPI2_#CS4 SPI2_#CS5 SPI2_#CS6 SPI2_#CS7 | 27 28 29 30 31 32 33 34 35 36 37 38

son On My Mac\..\FPG

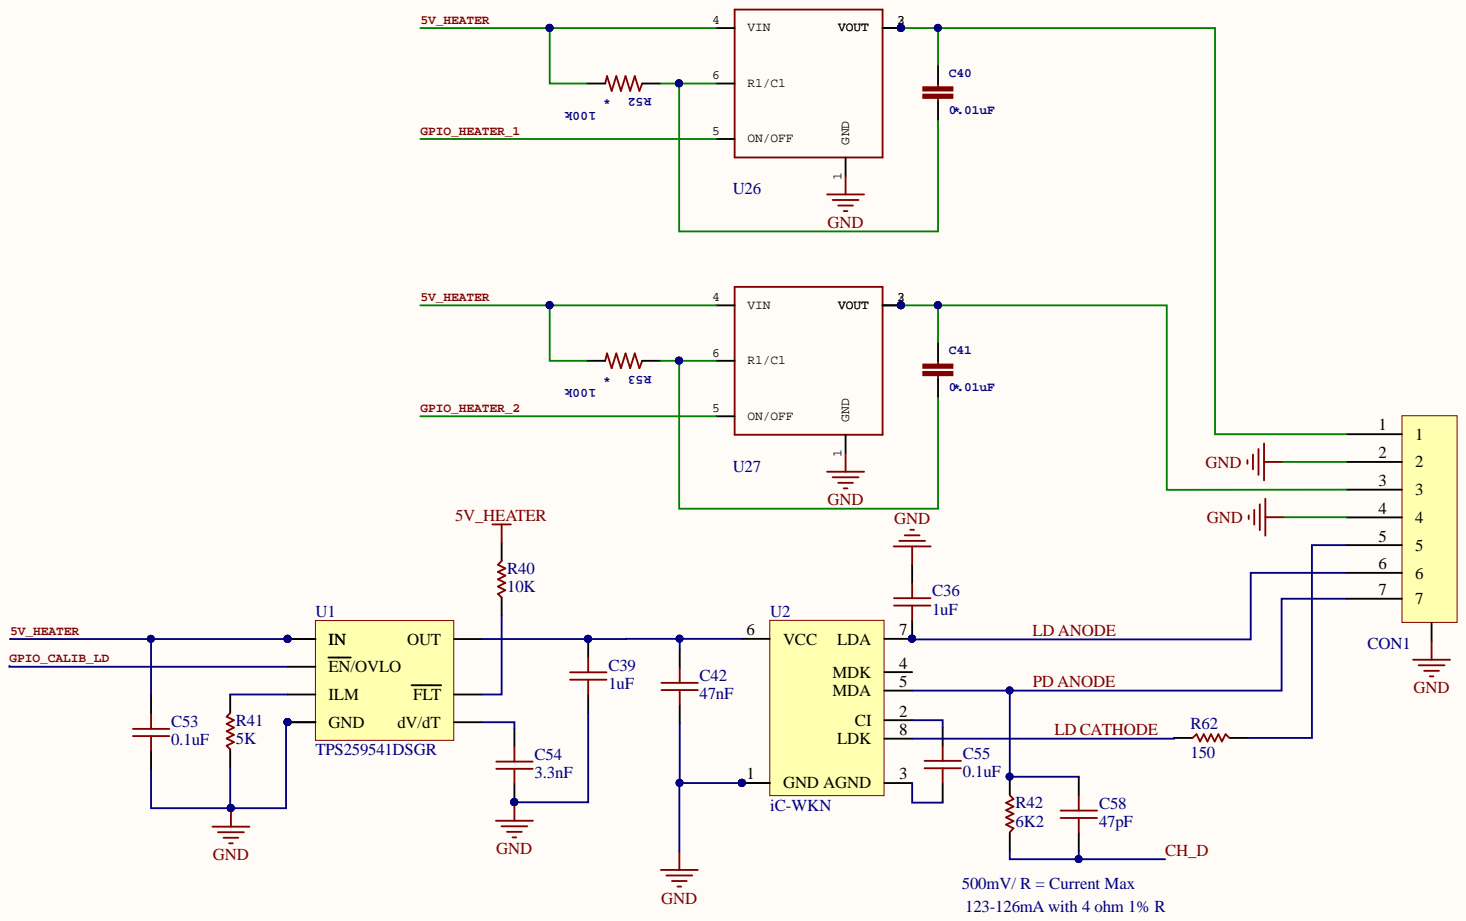
[picture p6: page 3]

C36 1uF LD ANODE | 7 7

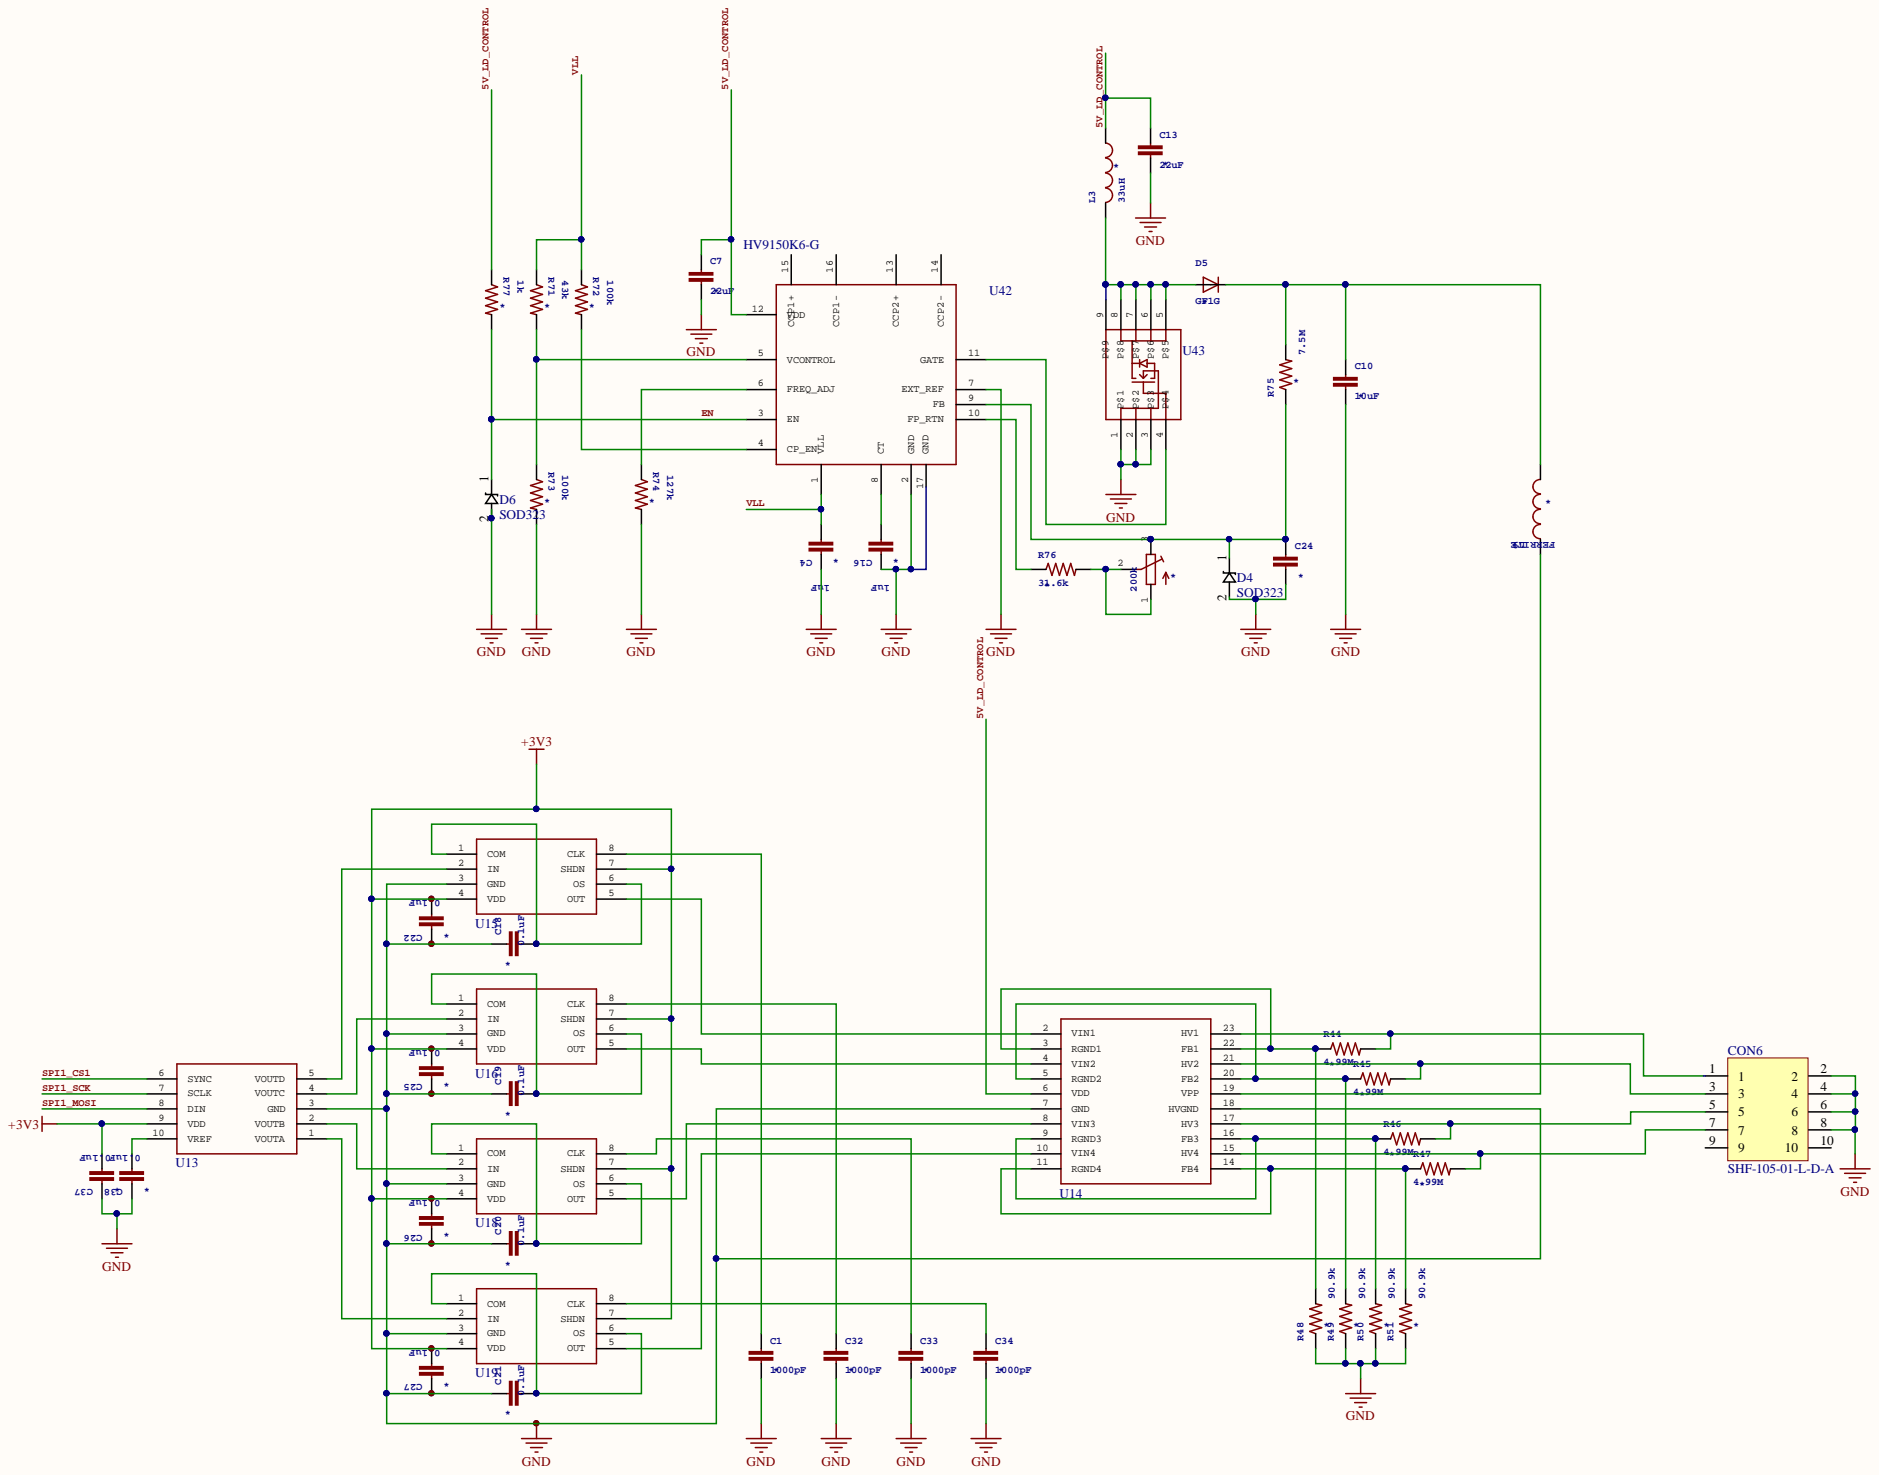
[picture p7: page 4]

COM 1 | OUT

VDD 4 IN 2 | 5 OS 6 SHDN 7 CLK 8

GND 3

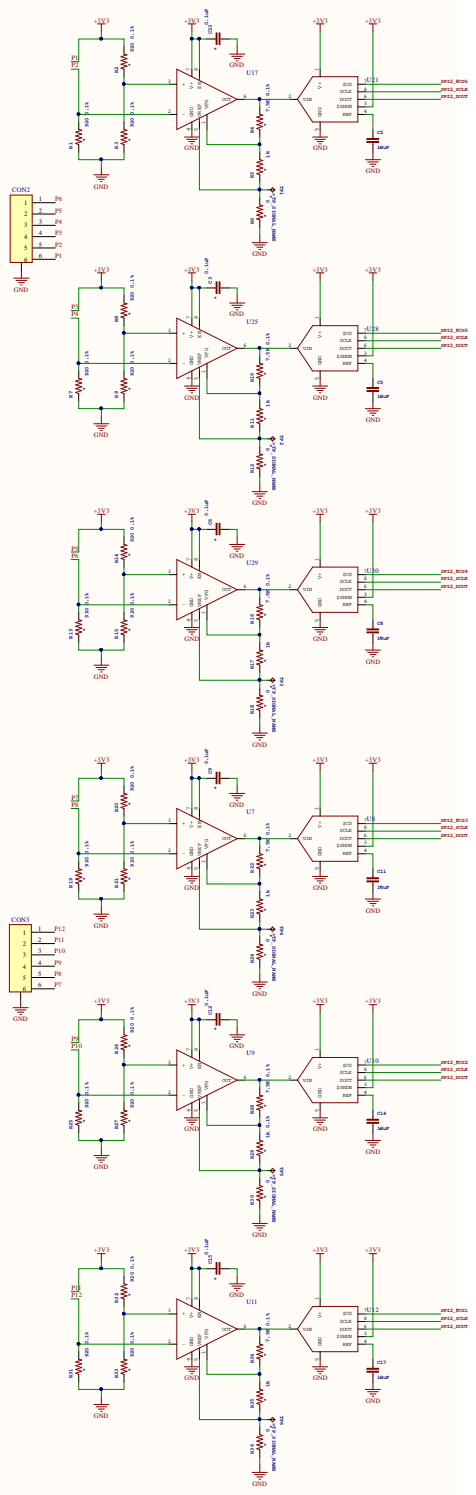
[picture p8: page 5]

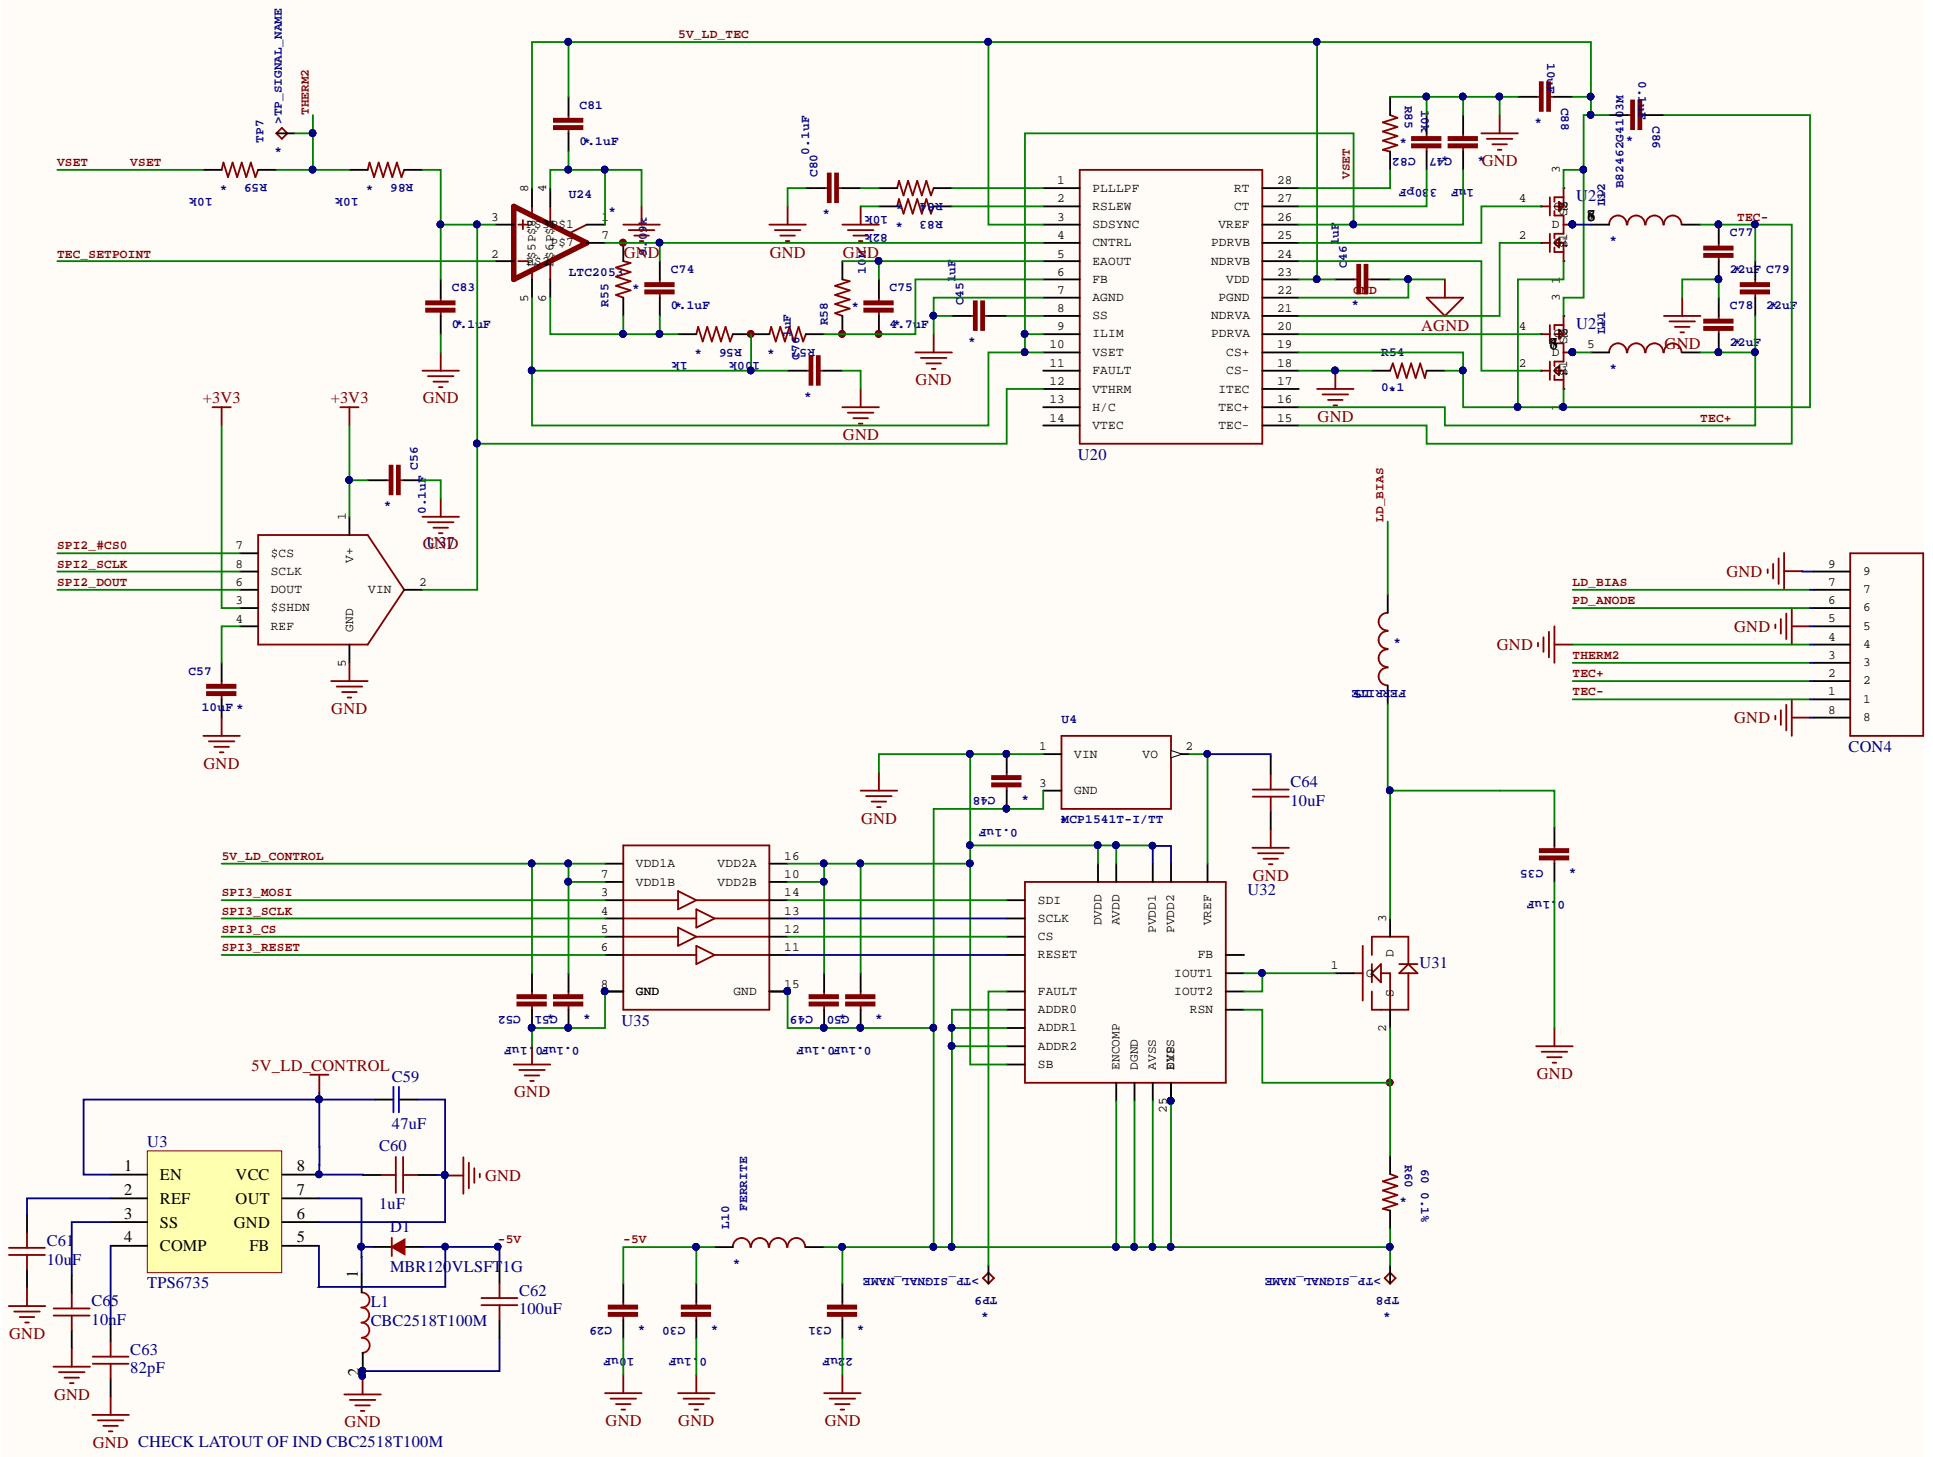
[picture p9: page 6]

RSLEW 2

U22 | TEC-

C75 | AGND 7 | | | GND

SS 8 | | | *
ILIM 9 | | | AGND | G2 4

* | | VSET 10

FAULT 11 | | | | | *

GND 3

GND

CHECK LATOUT OF IND CBC2518T100M

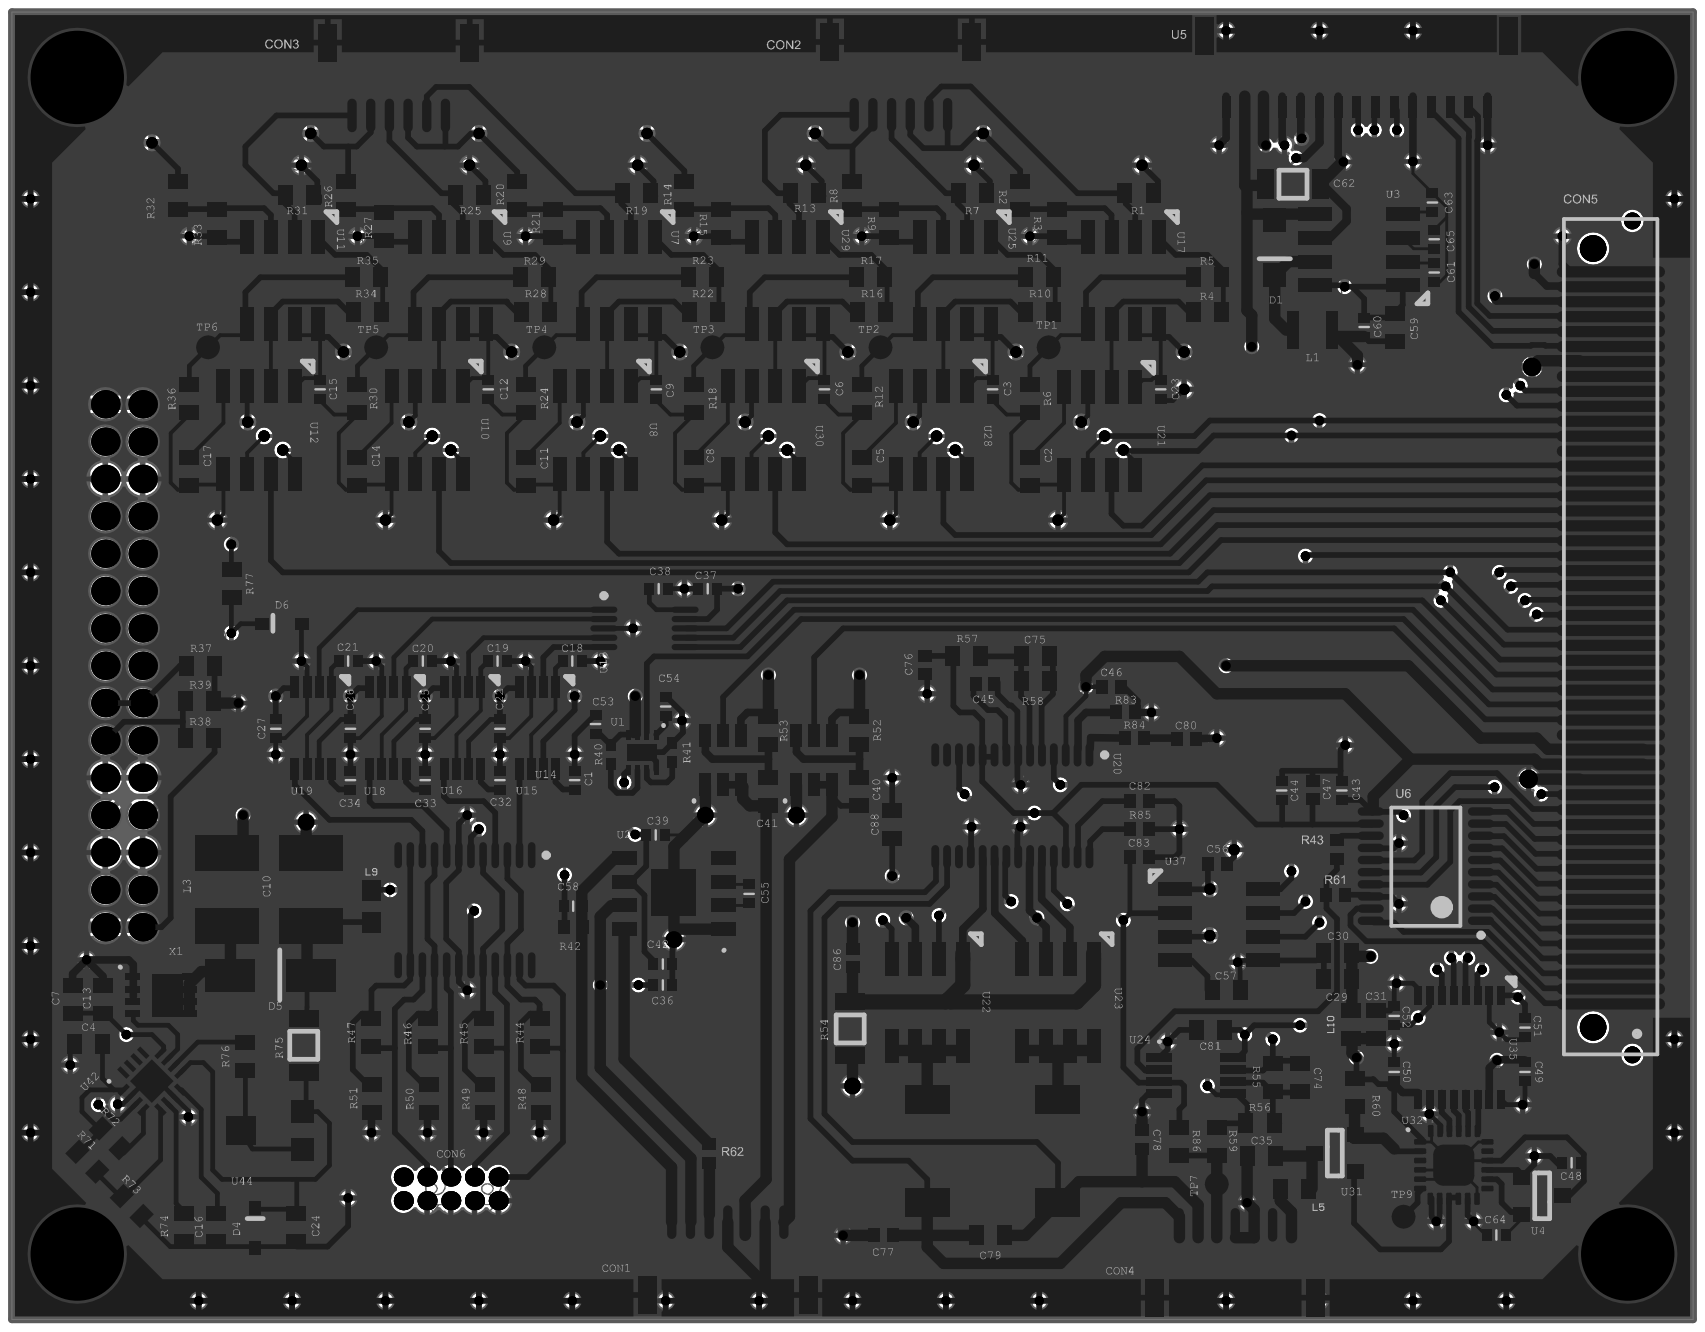
[picture p10: page 7]
