MIT-STARLab/CLICK-A-Electronics/Rpi Board/Rpiadapter_V3.pdf

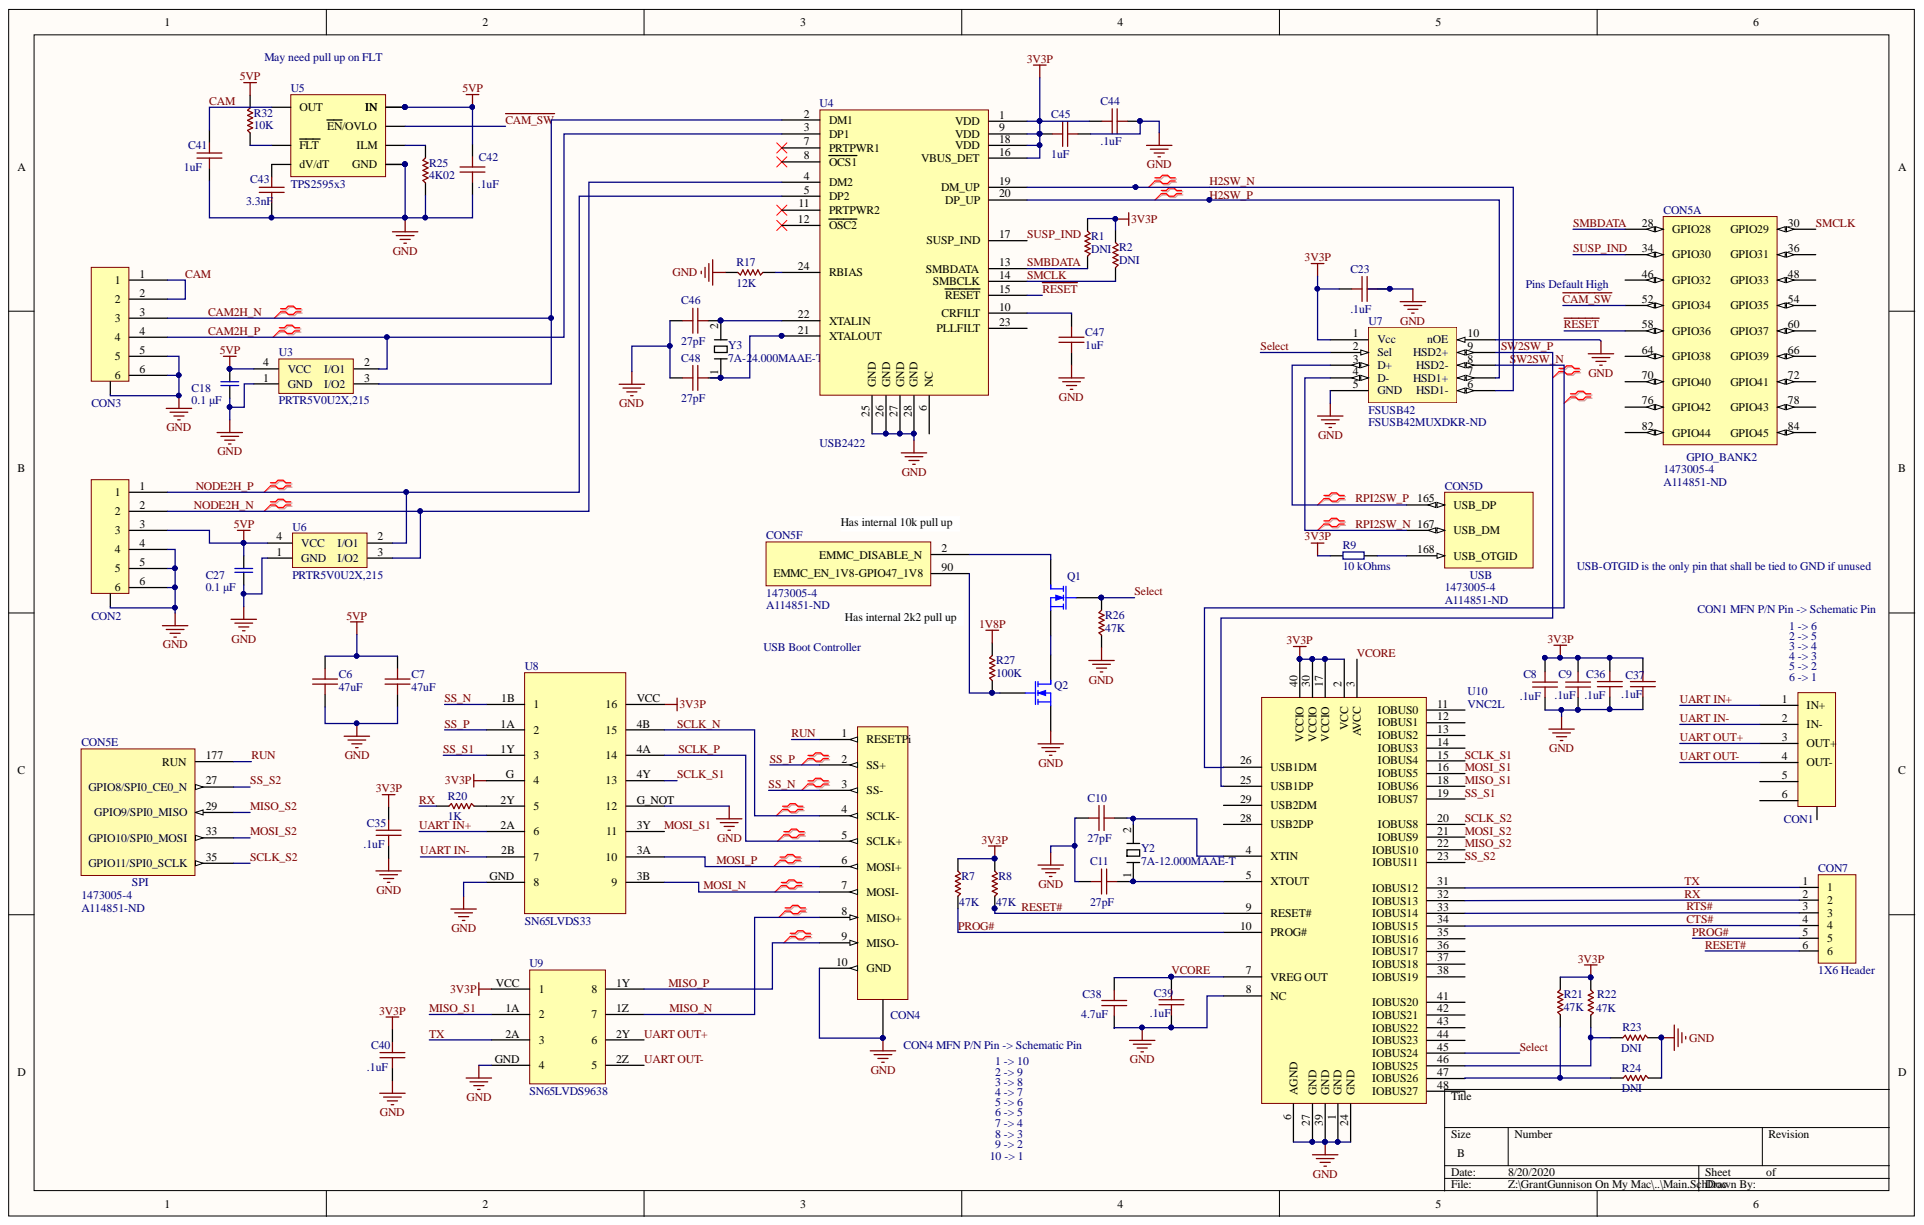
[picture p11: page 1]

May need pull up on FLT

Has internal 10k pull up

USB-OTGID is the only pin that shall be tied to GND if unused Q1

Has internal 2k2 pull up

CON1 MFN P/N Pin -> Schematic Pin

CON4 MFN P/N Pin -> Schematic Pin

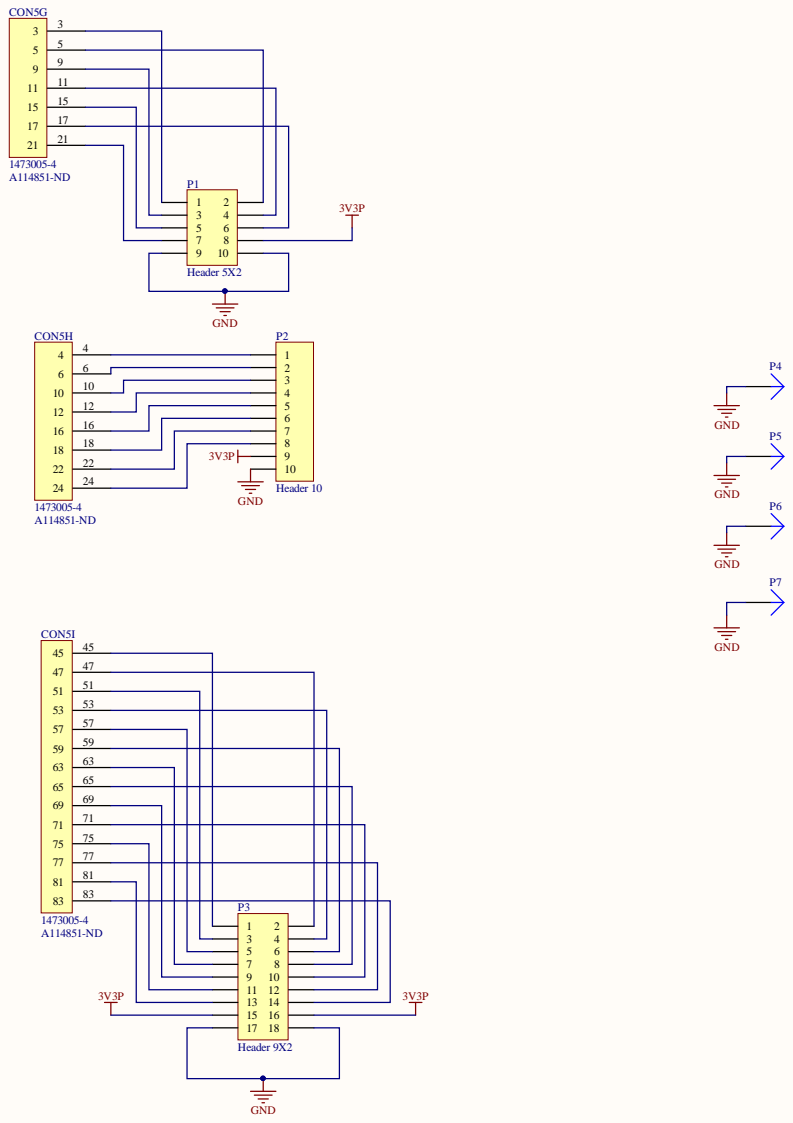
[picture p12: page 2]

1 2
3 4

5 6
7 8
9 10
11 12
13 14

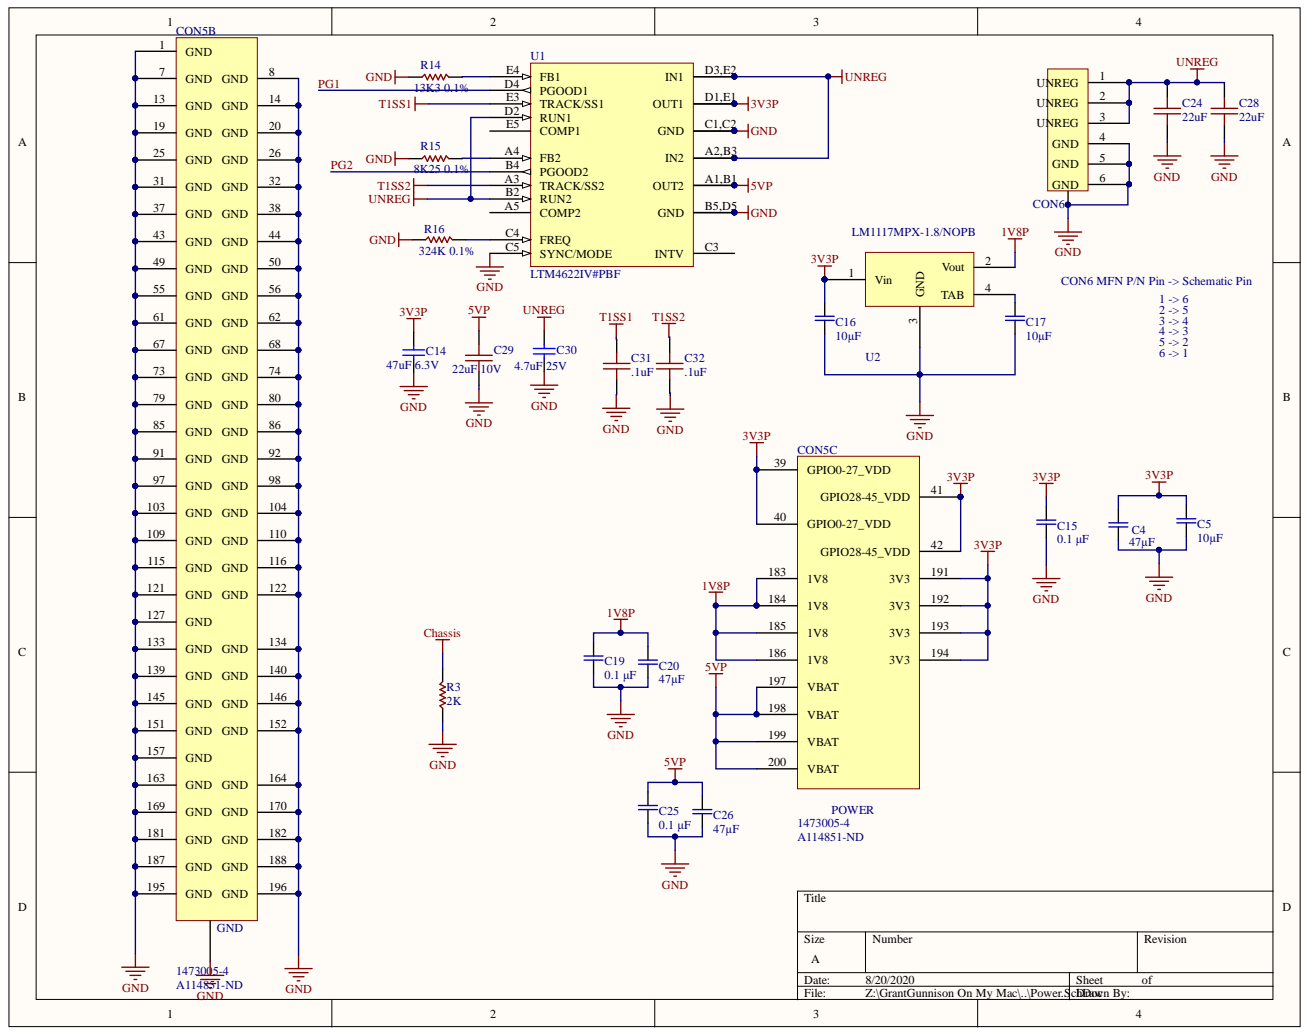
[picture p13: page 3]

CON6 MFN P/N Pin -> Schematic Pin

VBAT 198

VBAT 200

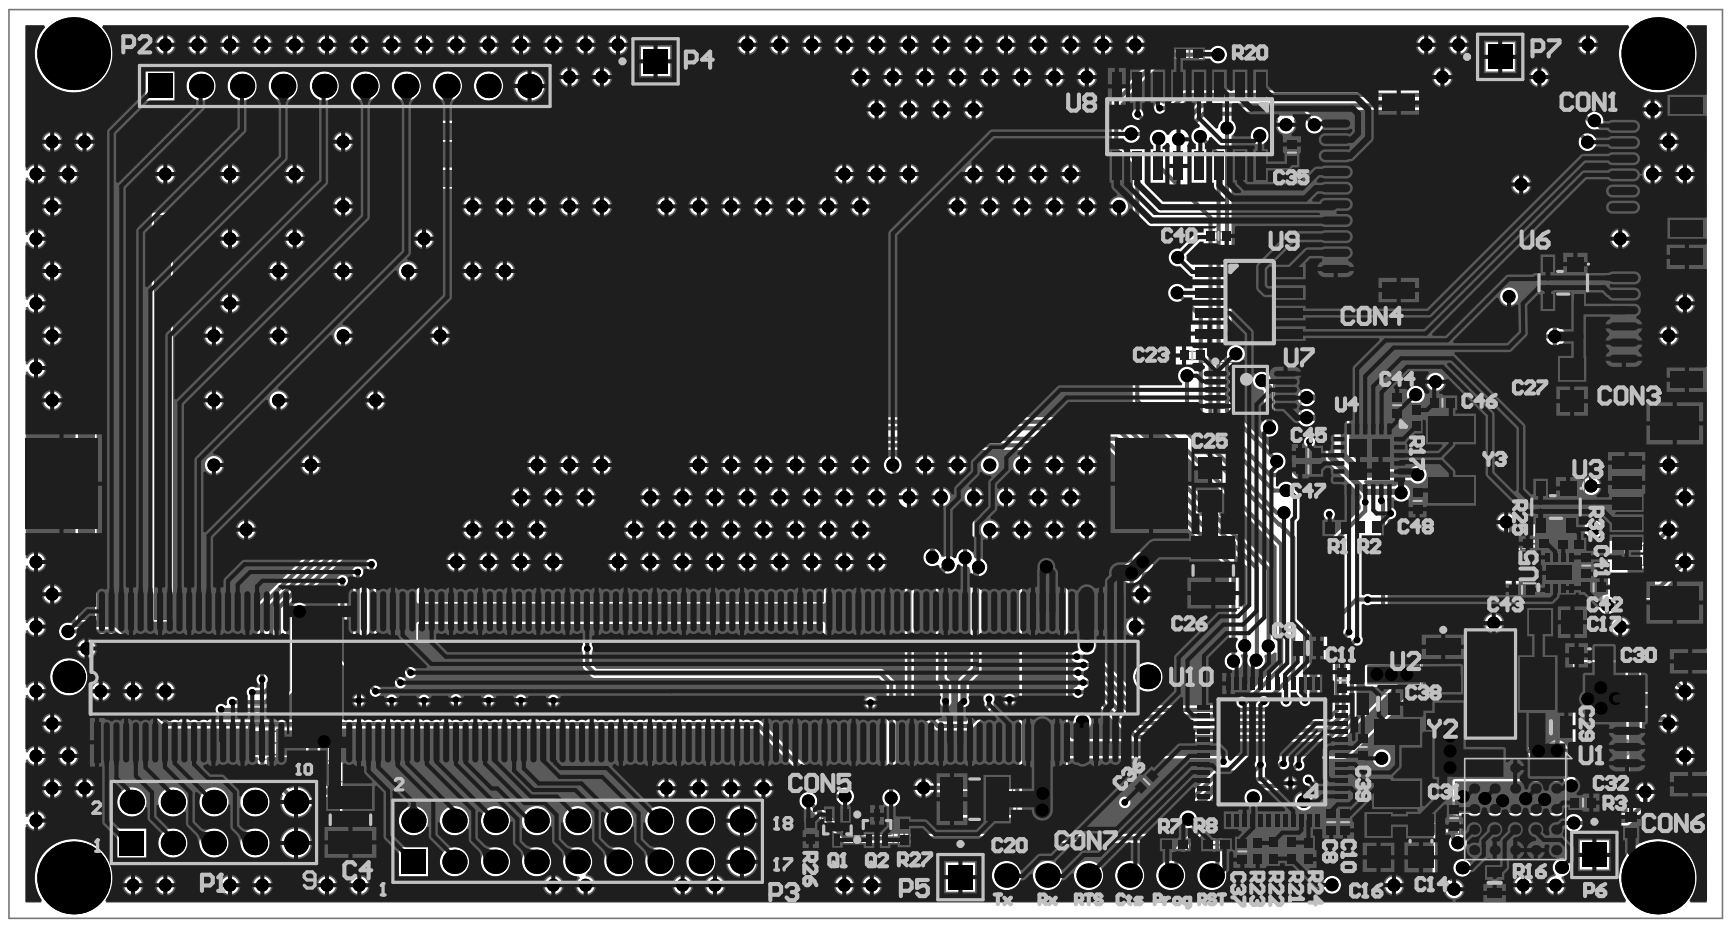
[picture p14: page 4]
