MIT-STARLab/CLICK-A-Electronics/Calibration Laser Board/Calibration_Laser_Board.pdf

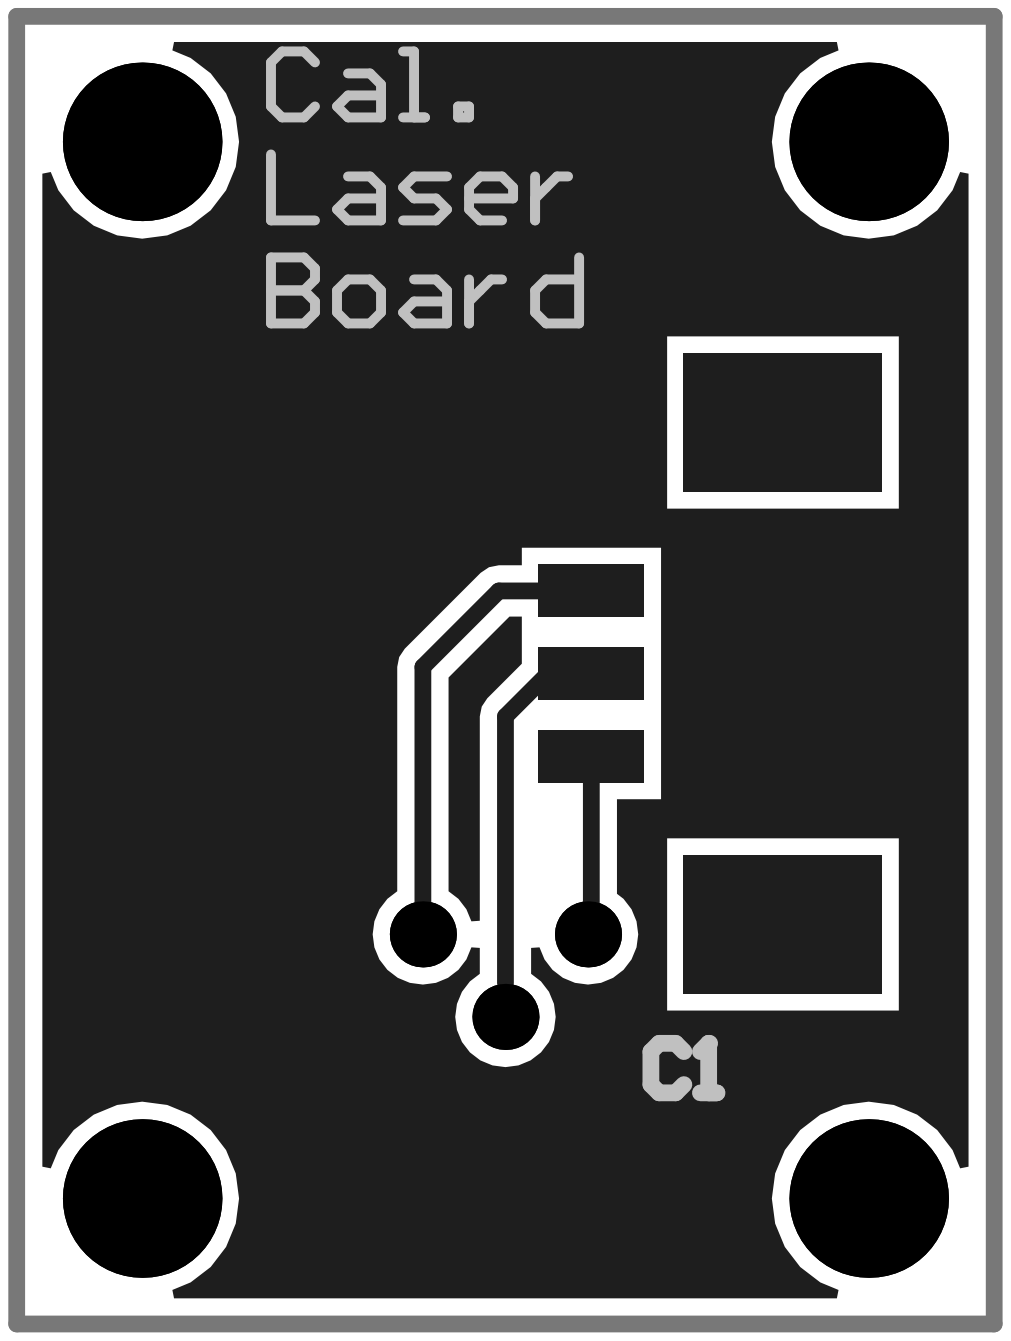
[picture p15: page 1]
