MIT-STARLab/CLICK-A-Electronics/FPGA/FPGA mask.pdf

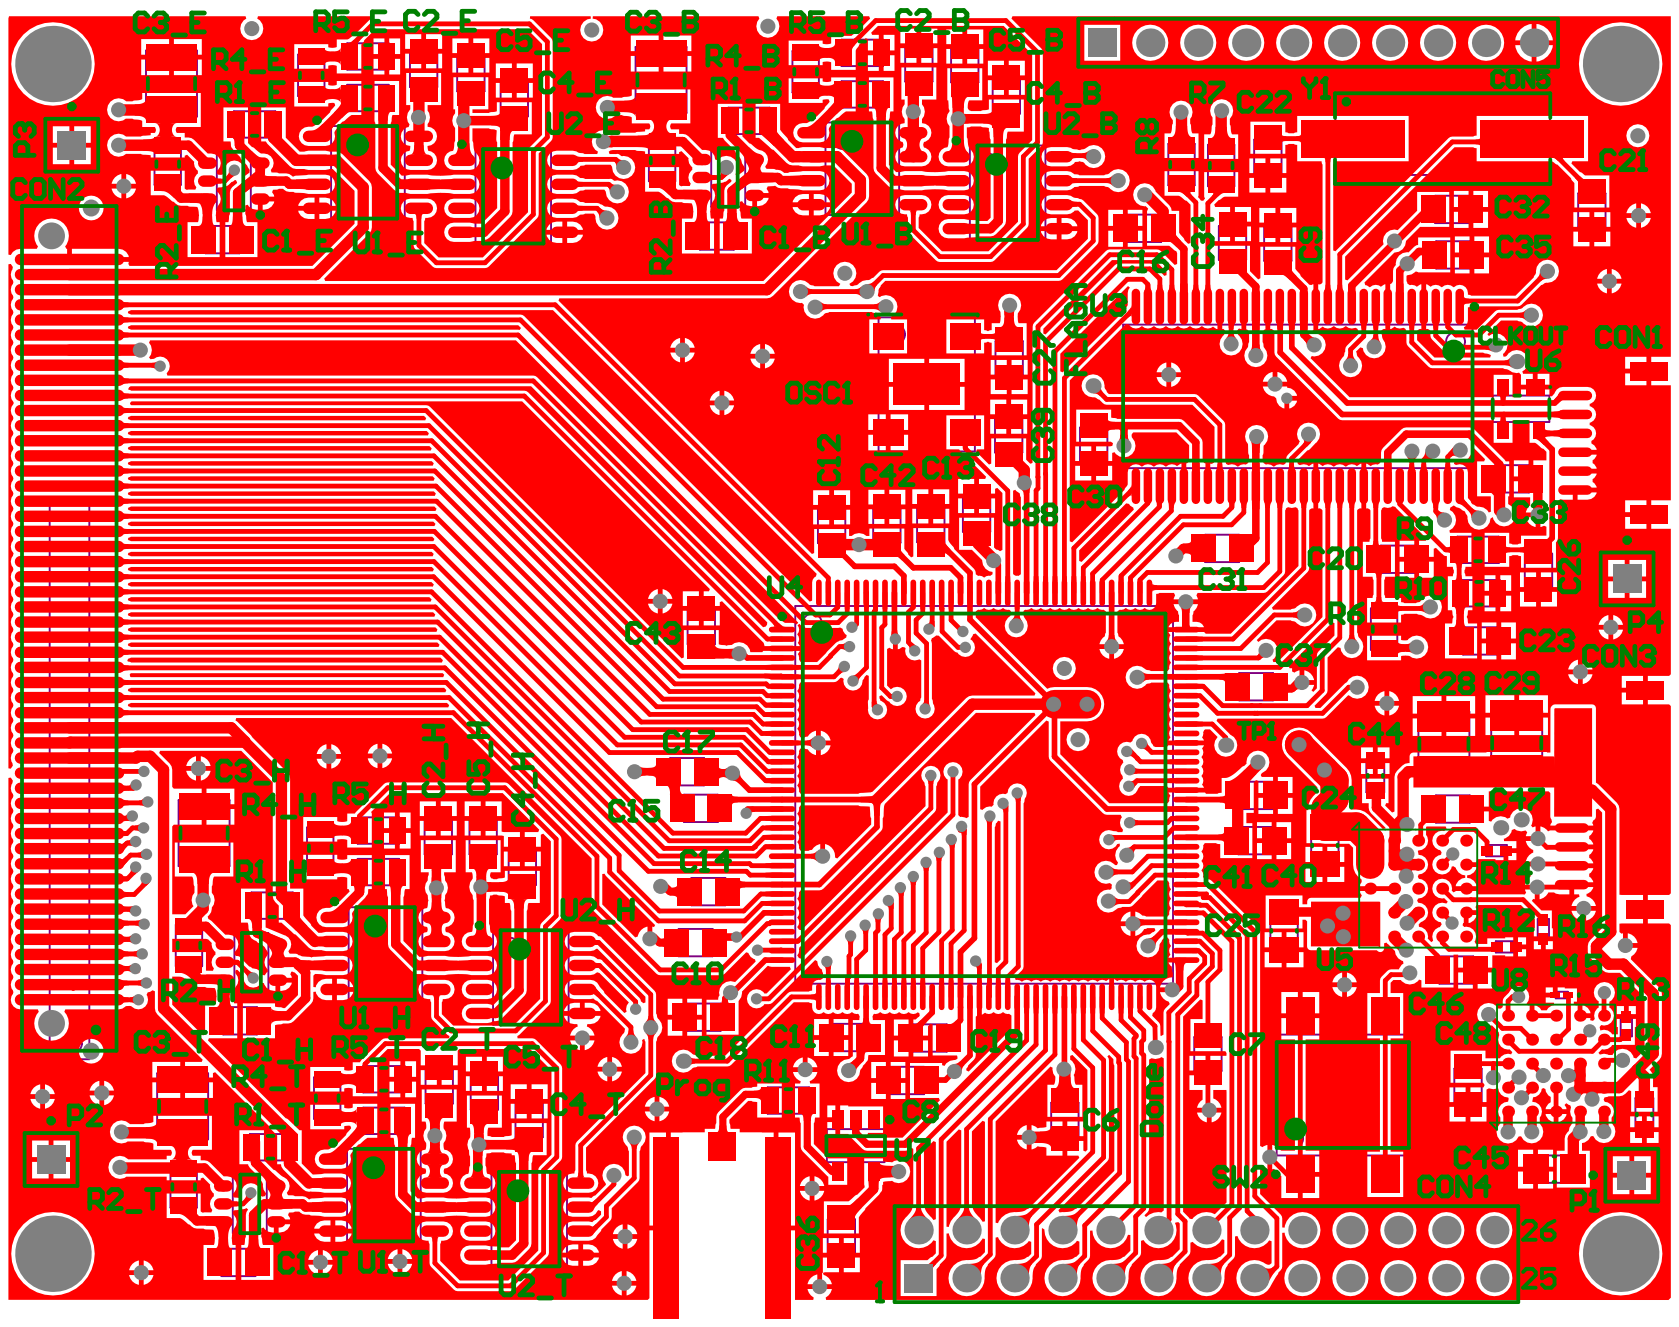
[picture p20: page 1]

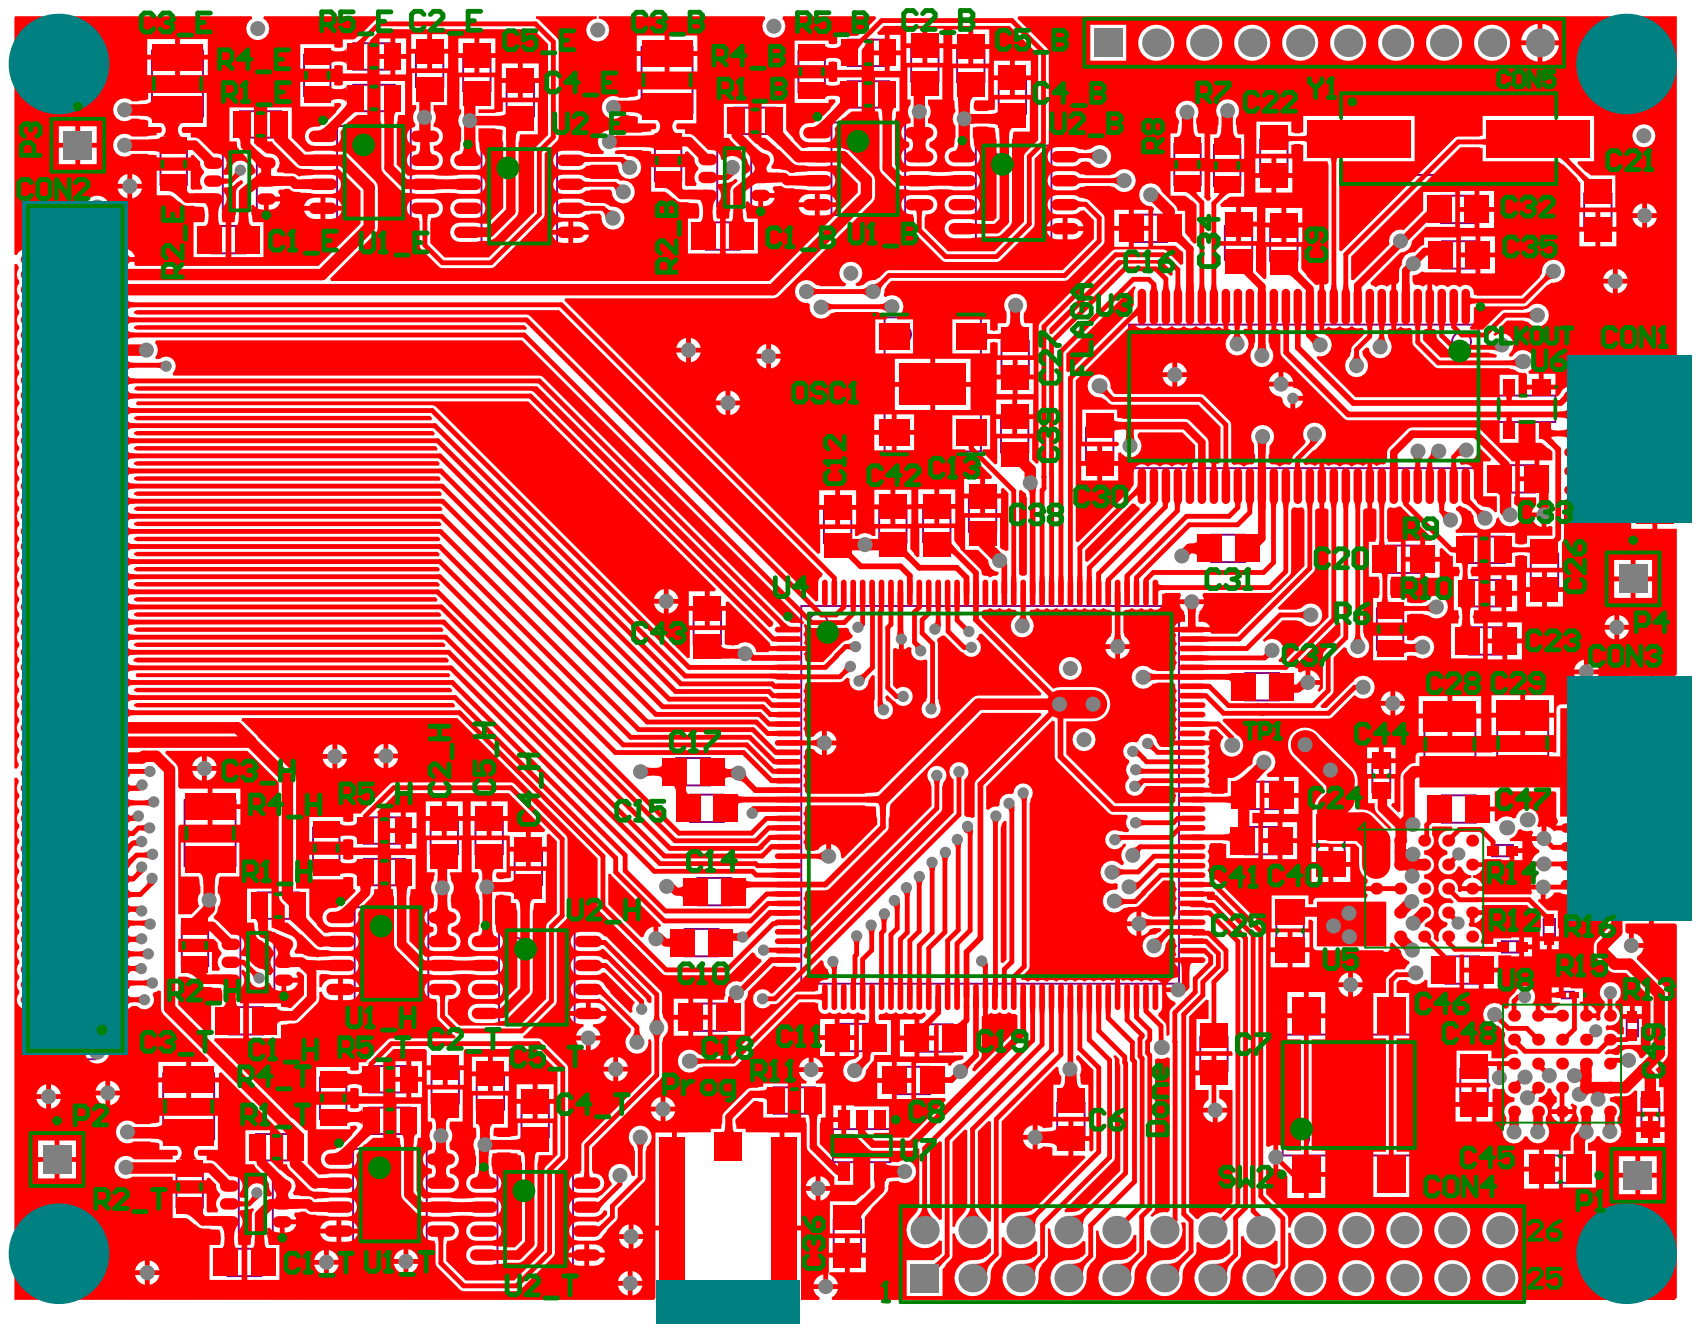
[picture p21: page 2]

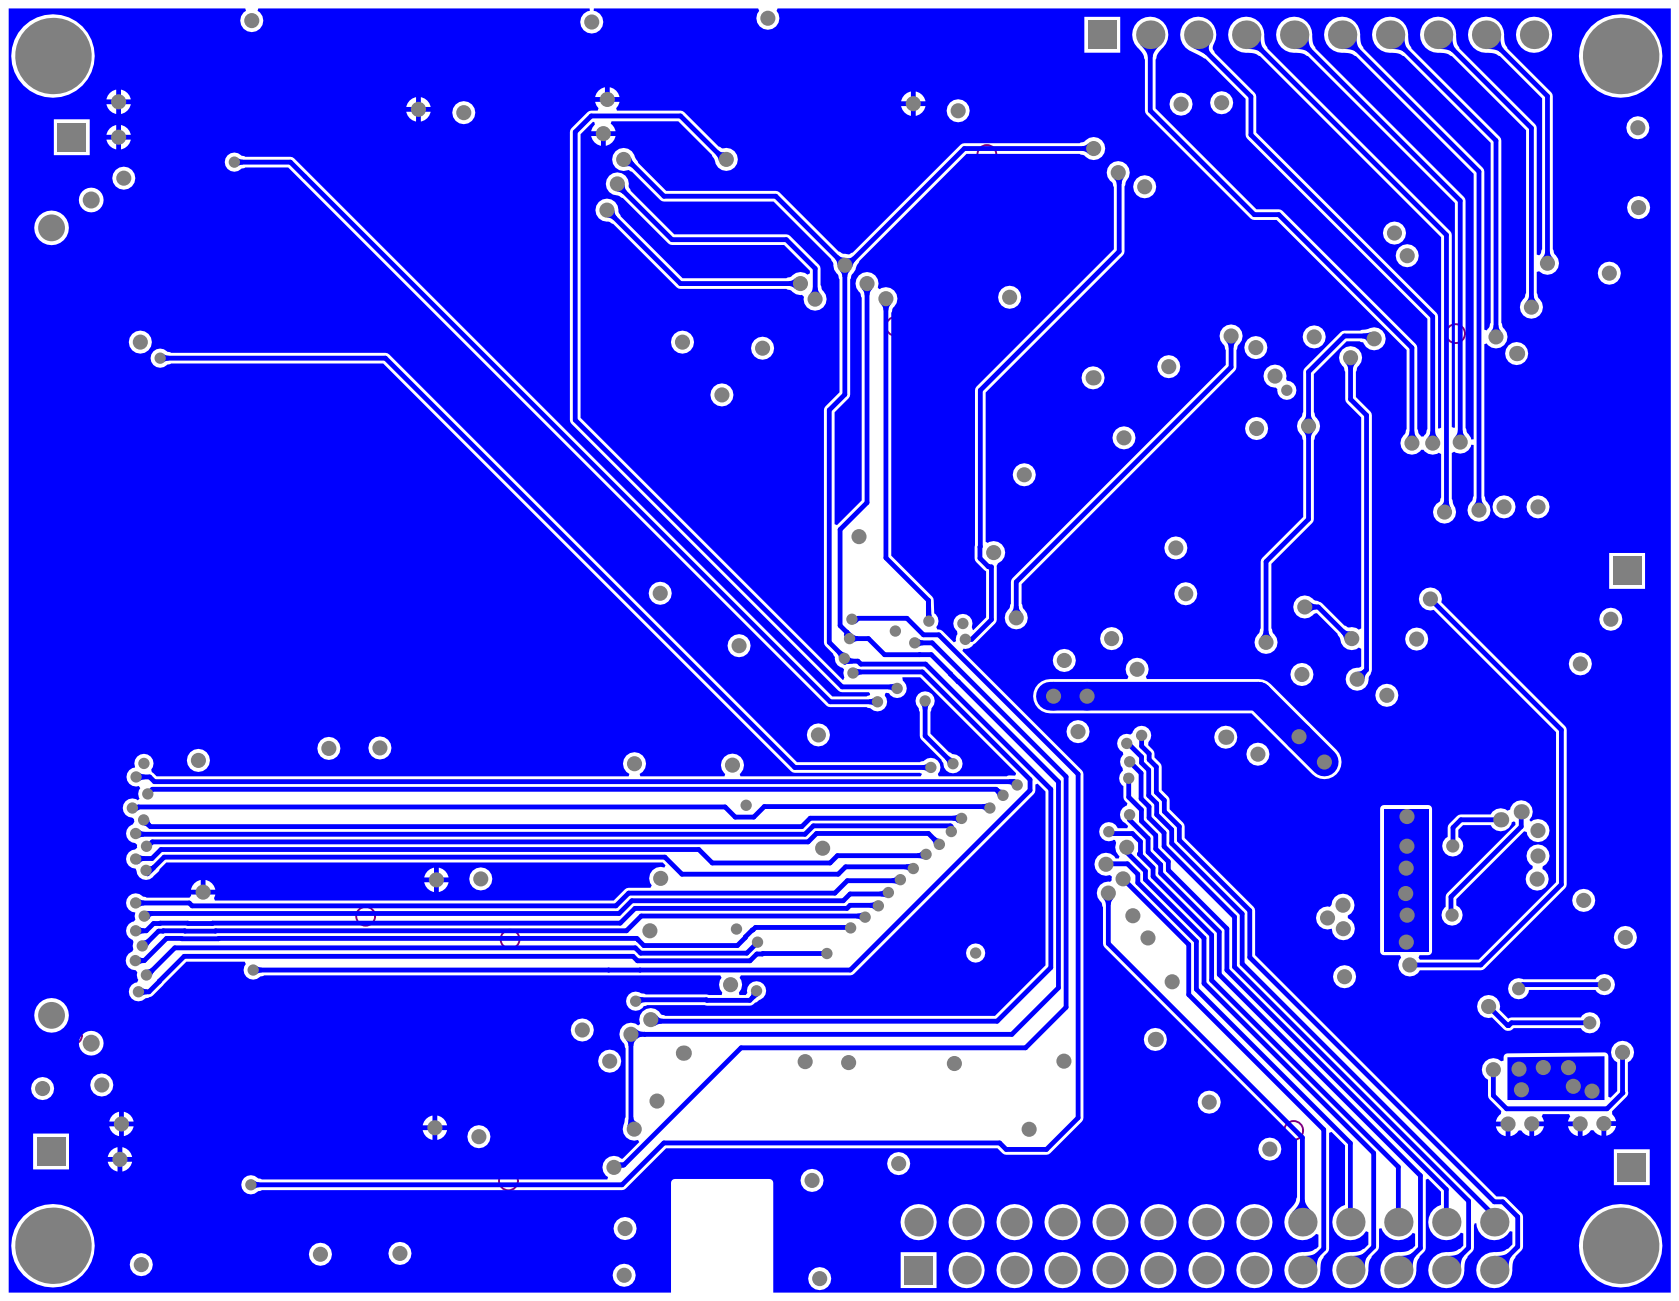
[picture p22: page 3]

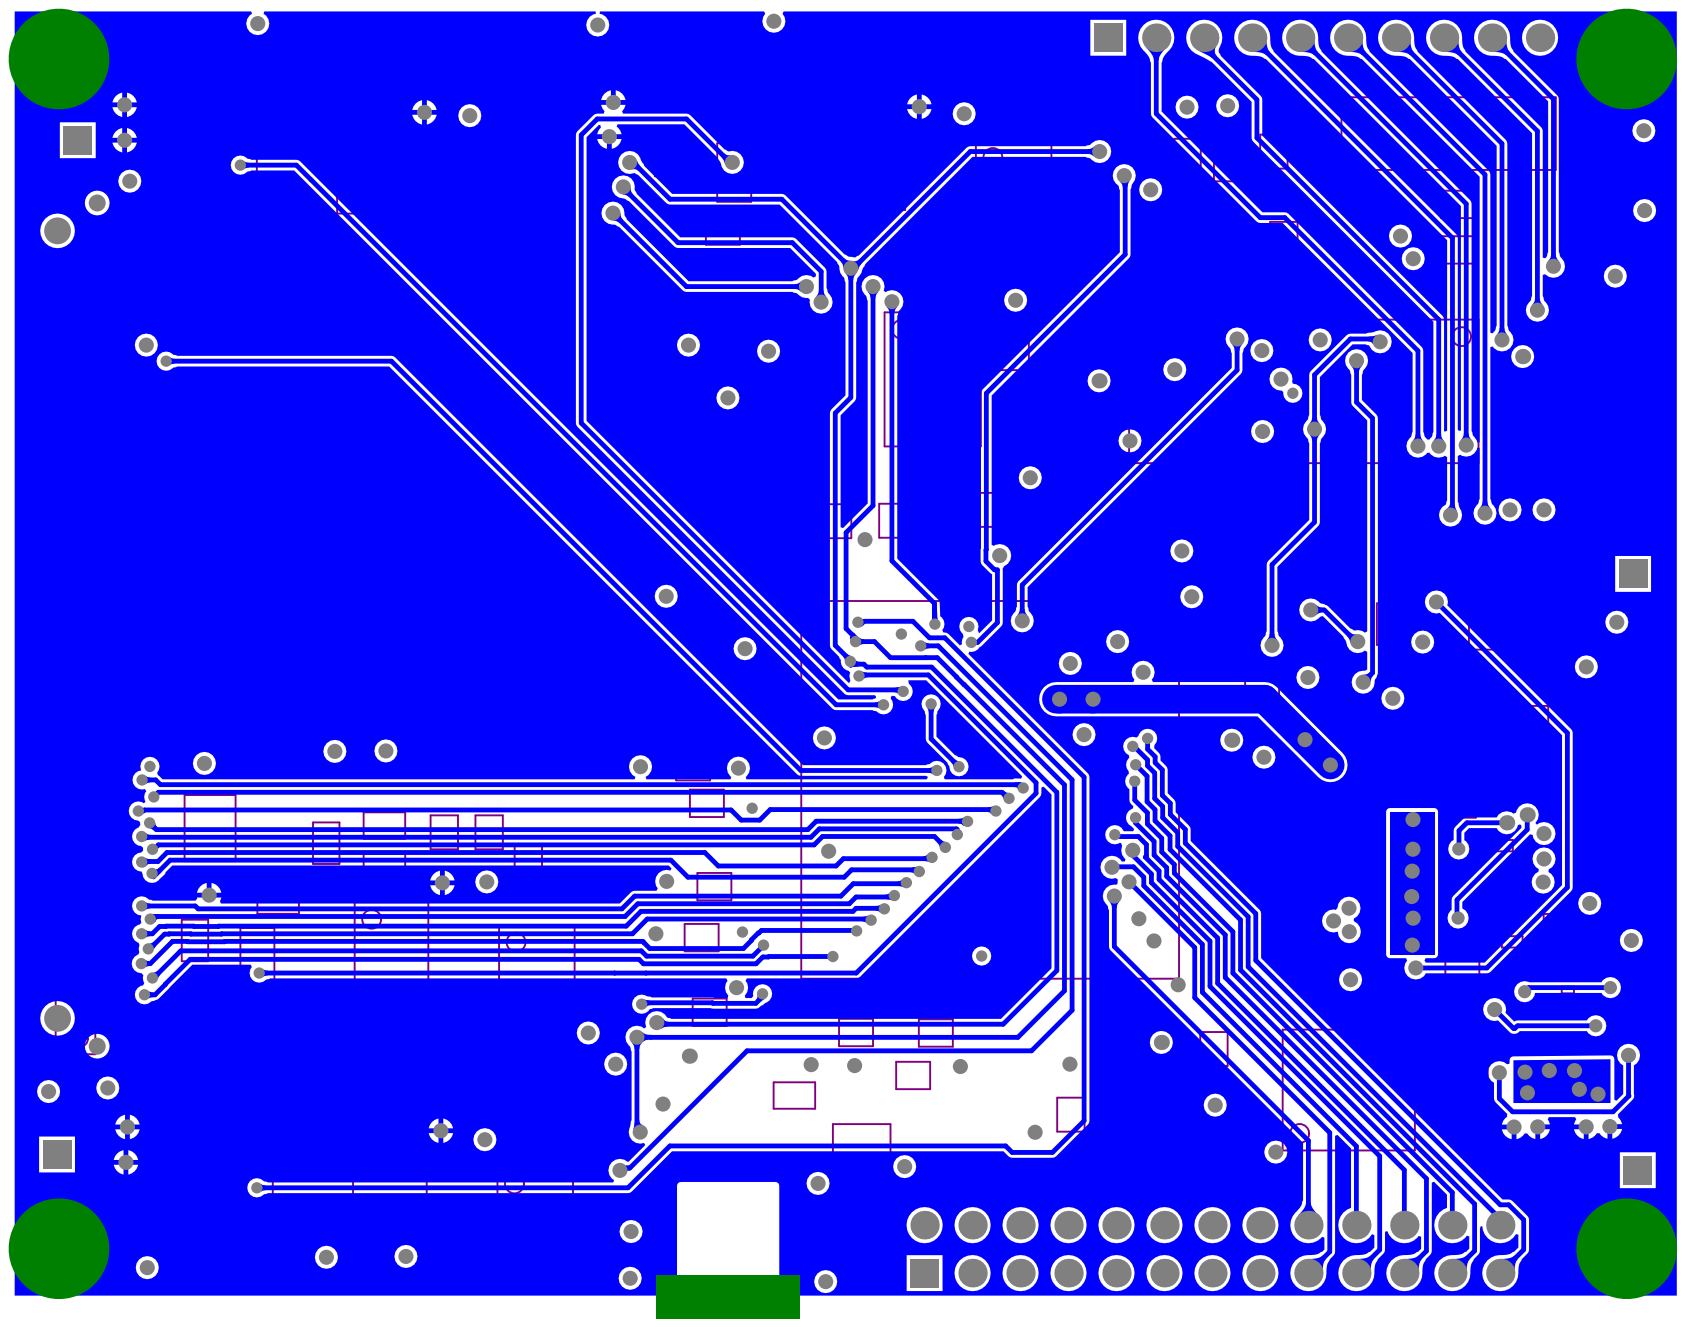
[picture p23: page 4]
