MIT-STARLab/CLICK-A-Electronics/FPGA/FPGAboard.pdf

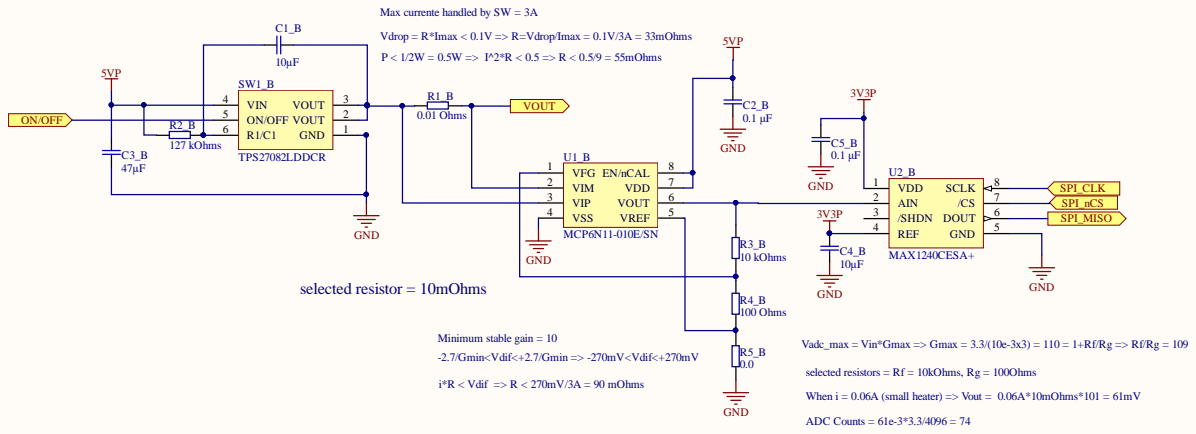
[picture p24: page 1]

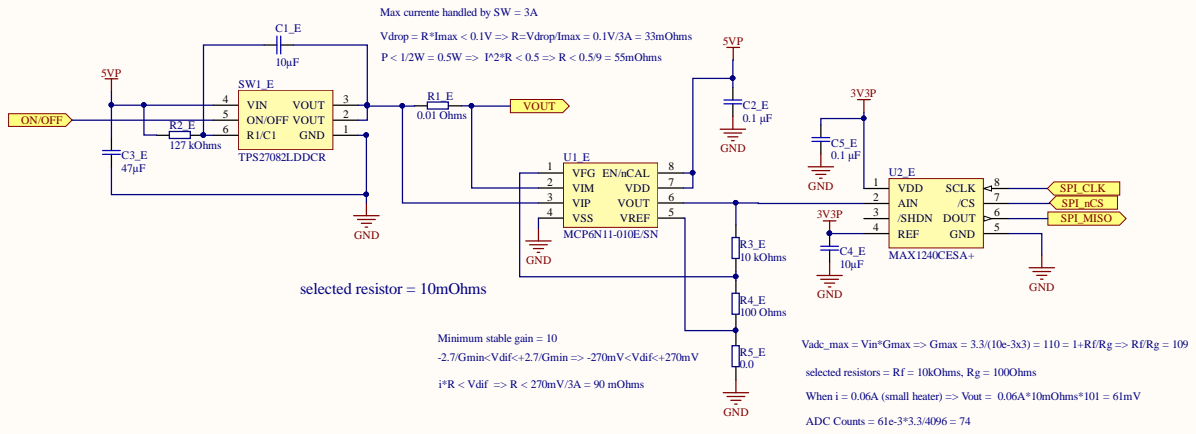
[picture p25: page 2]

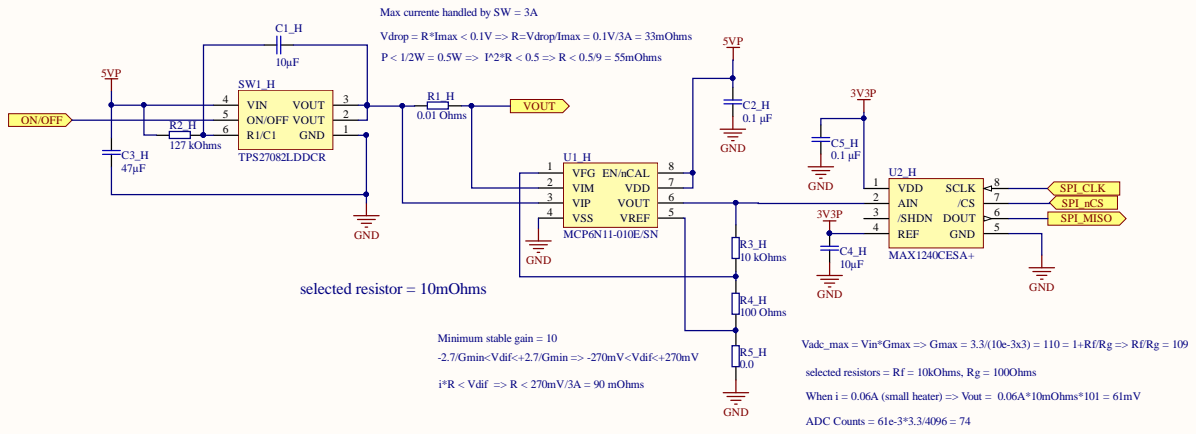
[picture p26: page 3]

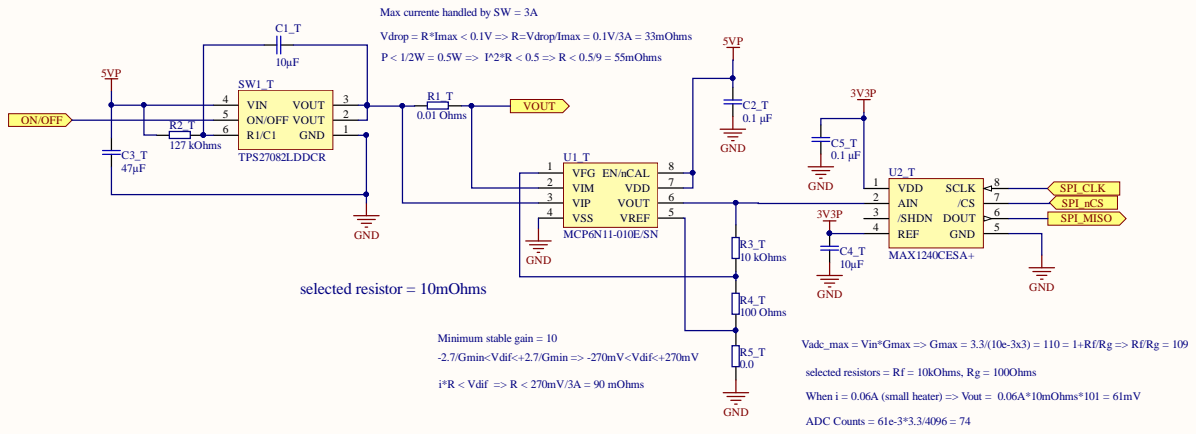
[picture p27: page 4]

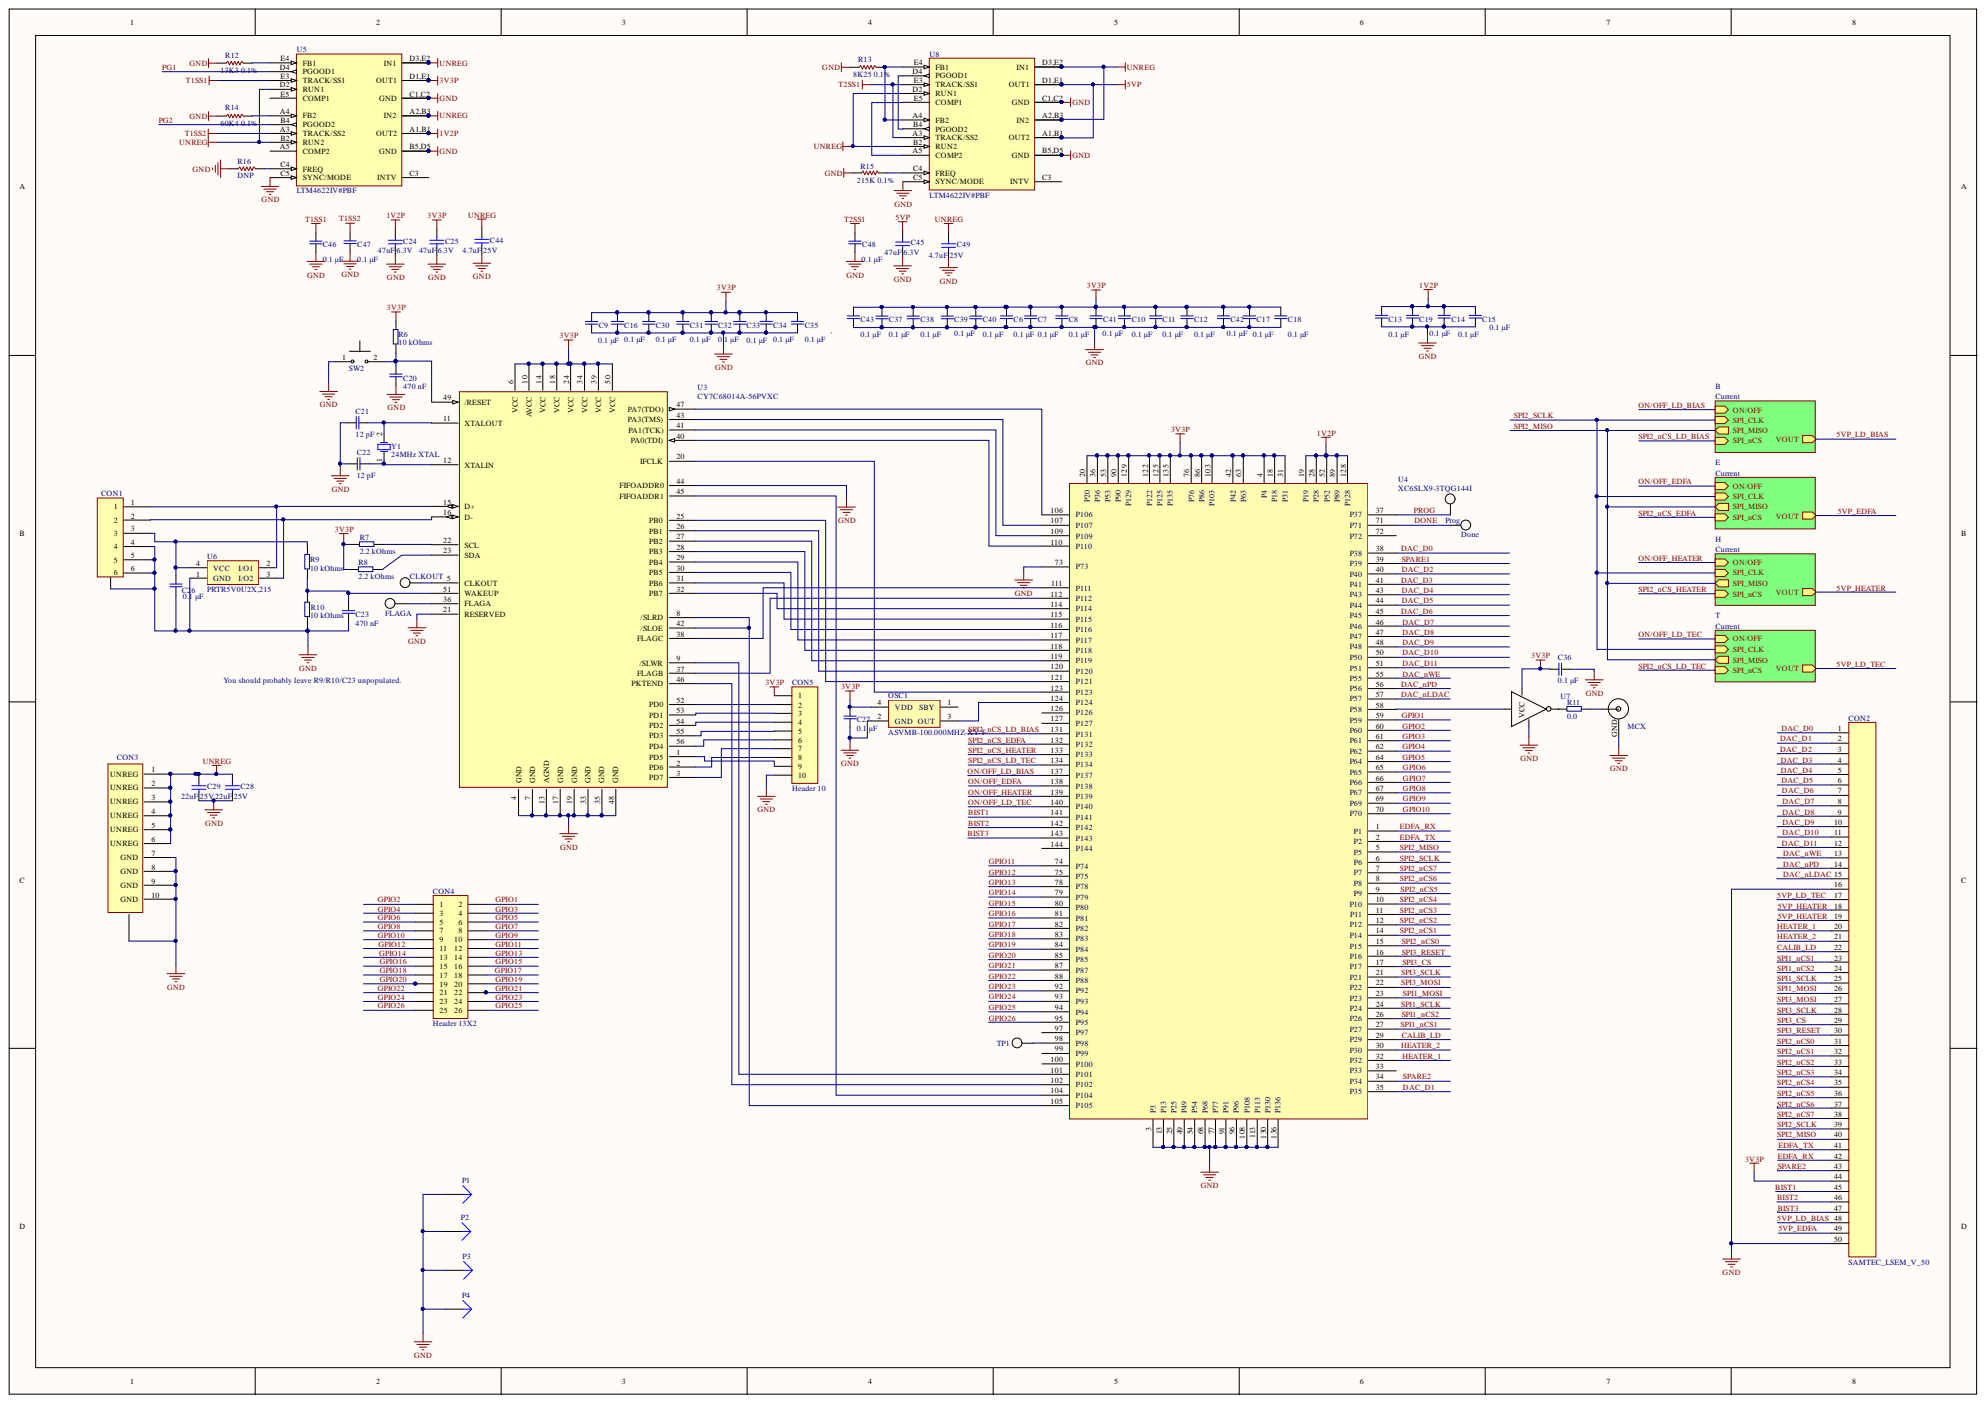
[picture p28: page 5]

You should probably leave R9/R10/C23 unpopulated.

1 2 3 4 5 6 7 8 9 10 | OSC1 | P124 124

P98 98 | CALIB_LD

P102 102
P104 104 | DAC_D1

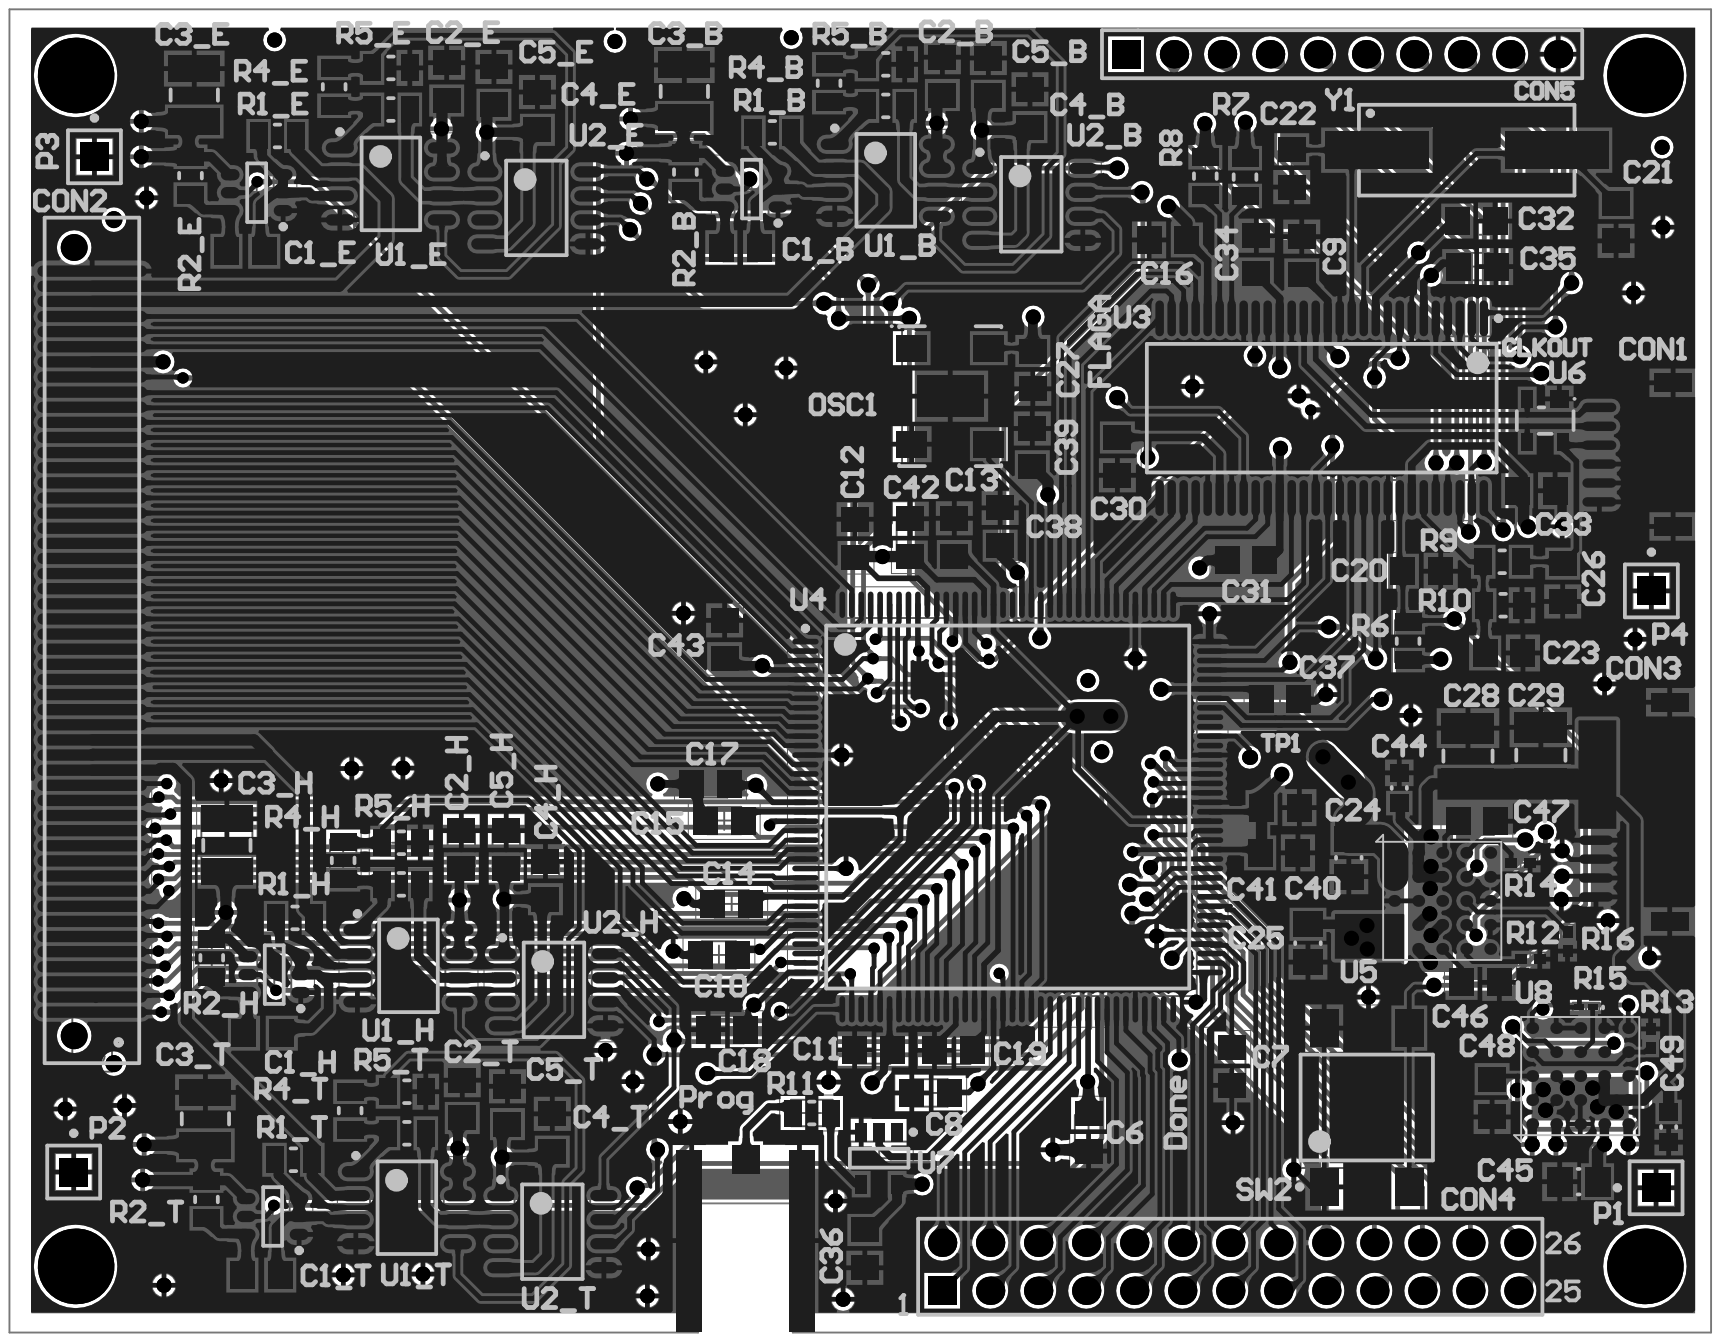
[picture p29: page 6]
