MIT-STARLab/CLICK-A-Electronics/(list of files, drawings)

Other design files:
Calibration Laser Board/Cal_Laser_Board.SchDoc
Calibration Laser Board/Calibration_Laser_Board.PcbDoc
Calibration Laser Board/Calibration_Laser_Board.PcbLib
Calibration Laser Board/Calibration_Laser_Board.PrjPCB
Calibration Laser Board/Calibration_Laser_Board.SchLib
Daughterboard/DaughterBoard.SchLib
Daughterboard/EDFA Connector.SchDoc
Daughterboard/FPGA Connect.SchDoc
Daughterboard/Heater & Cal. Laser.SchDoc
Daughterboard/HV Power Supply.SchDoc
Daughterboard/NODE_Daughter_Board_rev_16.PrjPcb
Daughterboard/RTDBank.SchDoc
Daughterboard/Seed Laser Controller.SchDoc
FPGA/FPGAboard.PrjPcb
FPGA/FPGAboard.SchDoc
FPGA/FPGAboard.SchLib
Photodiode Board/PhotodiodeBoard.PcbDoc
Photodiode Board/PhotodiodeBoard.PrjPCB
Photodiode Board/Photodiodeboard.SchDoc
Rpi Board/Main.SchDoc
Rpi Board/Misc.SchDoc
Rpi Board/Power.SchDoc
Rpi Board/Rpiadapter_V3.PrjPcb
Rpi Board/RPIadaptor.SchLib
Rpi Board/VCN1L.PcbLib
Rpi Board/VNC1L.SchLib
