MIT-STARLab/CLICK-A-Electronics/TOSA Board/TOSA_Board_5.brd

## EAGLE design TOSA Board/TOSA_Board_5.brd (2020-10-06)

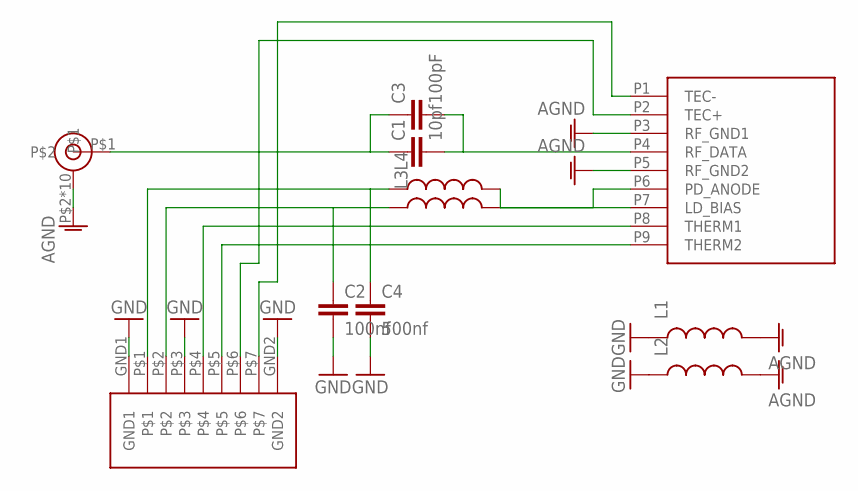
[picture p34: schematic TOSA_Board_5.sch]

Parts:
C1: 10pf; C0603K
C2: 100nf; C0603K
C3: 100pF; C0603K
C4: 500nf; C0603K
L1, L2, L3, L4: INDUCTOR30OHM,1.8A; 0603
U$2: TOSA; MSA-9
U$3: EDGE_MOUNT_MMCXMCX; EDGE_MOUNT_MCX
U$4: SAMTEC_T1M_X7; SAMTEX_T1M_X7

Connections:
AGND: L1.2, L2.2, U$2.P3 (RF_GND1), U$2.P5 (RF_GND2), U$3.P$2, U$3.P$3, U$3.P$4, U$3.P$5, U$3.P$6, U$3.P$7, U$3.P$8, U$3.P$9, U$3.P$10, U$3.P$11
GND: C2.2, C4.2, L1.1, L2.1, U$4.GND1, U$4.GND2, U$4.P$3
LD_BIAS: C4.1, L4.1, U$4.P$1
unnamed: C1.1, C3.1, U$3.P$1
unnamed: C1.2, C3.2, U$2.P4 (RF_DATA)
unnamed: L3.2, U$2.P6 (PD_ANODE)
unnamed: L4.2, U$2.P7 (LD_BIAS)
PD_ANODE: C2.1, L3.1, U$4.P$2
TEC+: U$2.P2 (TEC+), U$4.P$6
TEC-: U$2.P1 (TEC-), U$4.P$7
THERM1: U$2.P8 (THERM1), U$4.P$4
THERM2: U$2.P9 (THERM2), U$4.P$5

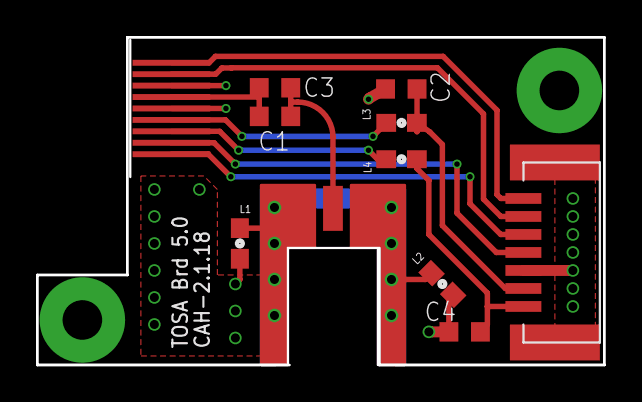
[picture p35: board TOSA_Board_5.brd from above]

Board: 4 copper layers, 31.5 x 18.2 mm, 11 parts (0 on the bottom side), 12 nets.
