MIT-STARLab/CLICK-A-Electronics/(commit log)

2020-10-05 Adding CPU board
    [Main.SchDoc, Misc.SchDoc, Power.SchDoc, RPIadaptor.SchLib, RPIadaptorV3_BOM.xlsx, Rpiadapter_V3.PrjPcb, VCN1L.PcbLib, VNC1L.SchLib]
2020-10-05 Adding Daughter board
    [DaughterBoard.SchLib, Daughter_Board_rev_16_updated.xls, EDFA Connector.SchDoc, FPGA Connect.SchDoc, HV Power Supply.SchDoc, Heater & Cal. Laser.SchDoc, NODE_Daughter_Board_rev_16.PrjPcb, RTDBank.SchDoc]
2020-10-05 Adding FPGA board
    [BOM_FPGAboard.xlsx, FPGAboard.PrjPcb, FPGAboard.SchDoc, FPGAboard.SchLib]
2020-10-06 Adding TOSA and calibration laser boards
    [Cal_Laser_Board.SchDoc, Calibration_Laser_Board.PcbDoc, Calibration_Laser_Board.PcbLib, Calibration_Laser_Board.PrjPCB, Calibration_Laser_Board.SchLib, Calibration_Laser_Board.step, TOSA_Board_5.brd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]
2020-10-06 Adding Photodiode board
    [PhotodiodeBoard.PcbDoc, PhotodiodeBoard.PrjPCB, PhotodiodeBoard.xlsx, Photodiodeboard.SchDoc]
